CZ-Infokom/GeigerNode/GeigerNode Firmware Development.md

# GeigerNode Firmware — Master Development Prompt

You are developing firmware and performing hardware bring-up for a custom PCB called GeigerNode.

The firmware must be written for bare AVR silicon using the GNU AVR toolchain. Do not introduce Arduino, PlatformIO, vendor HALs, bootloaders, or unnecessary abstraction layers.

The immediate goal is SAFE HARDWARE BRING-UP of newly manufactured PCBs using an Atmel-ICE programmer.

Do not jump ahead to the complete firmware. Work through the bring-up phases in order and stop at explicit checkpoints.

Agent directives for this repository live in `.cursor/rules/`. This file remains the plan. The PROJECT STATUS section below is the persistence layer: update it when the phase, a checkpoint, a decision, or the stopping point changes. Numbered hardware, safety, and fuse sections stay as written unless the user changes those requirements.

======================================================================
PROJECT STATUS
======================================================================

Last updated: 2026-11-08

Where we are:
- Release `v0.2.1` is this commit, tagged on local `master` on 2026-11-08. Protocol version stays `2`. `GN_FW_PRE` is `0`, so `0x39`..`0x3C` are `00 02 01 00`. Capabilities `0x1F` (bit 4 = short-slice peaks). Map length is `0x50`. Host viewer: a chart with more than one trace draws each legend label as a switch; a click hides that trace and strikes the label through. History charts use the actual sample span on the time axis; the left edge is the oldest sample and the right edge is the newest. A full read of either latched peak still resets both latched values unless a newer slice raised the latch after the frozen snapshot. Each bank stores that latch generation. A consume that straddles the one-second publish keeps the new spike, including when NACK lands after the consume check and before the new winner is recorded. `make PROTOCOL=native` built text 15724, data 32, bss 1597, static RAM 1629, stack room 419, highest address `0x3D8B`. `make PROTOCOL=radsens` built text 8854, data 18, bss 825, static RAM 843, stack room 1205, highest address `0x22A7`. Host `make math-test` and `python3 firmware/host/viewer/test_decode.py` passed. Adversarial review before the tag: GPT, Gemini, and Opus hit a usage limit and fell back to Grok plus three inherit-critic passes. Round 1 found the latched-peak wipe; that and the remaining NACK-before-note hole are fixed in this image. No remaining hard blockers. Not pushed. Do not write fuses. Stay clear of the HV section. Do not raise 380 V or 2400 Hz.
- Host viewer time axis, 2026-11-08. History charts no longer snap elapsed time to round steps. The left edge is the oldest sample and the right edge is the newest, so a 0..90 s trace stays 0..90 s. The value axis still uses four round steps and the near-zero snap. Log time still maps that same actual span. Host `python3 firmware/host/viewer/test_decode.py` passed. Do not write fuses.
- Host viewer trace toggles, 2026-11-08. A chart with more than one trace draws each legend label as a switch. A click hides that trace and strikes the label through; another click draws it again. The value axis uses only the traces still drawn. A chart with one trace has no switch. Host `python3 firmware/host/viewer/test_decode.py` passed. Do not write fuses.
- Tag `v0.2.1-beta.4` is this commit on `feature/native-v2`, 2026-11-08. Annotated. Not merged to `dev` or `master`. Protocol version stays `2`. `GN_FW_PRE` is `4`, so `0x39`..`0x3C` are `00 02 01 04`. Capabilities `0x1F` (bit 4 = short-slice peaks). Map length is `0x50`. Bytes `0x00`..`0x3C` do not move. `0x3D` is reserved. `0x3E` is the peak span, 10..60 s, default 10, stored in EEPROM record version 2. A valid version-1 record still loads window, holdoff, and calibration, and the span stays 10 s. `0x40`/`0x48` are the window maximum (CPM × 10 and nSv/h) over the busiest full peak-span slice still inside the dose window. `0x44`/`0x4C` are the latched maximum since the previous consume. A full read of either latched register resets both latched values unless a newer slice raised the latch after that snapshot. An accepted span write clears both peaks. No peak updates until a full slice exists. RadSens is unchanged. `make PROTOCOL=native` built text 15582, data 32, bss 1593, static RAM 1625, stack room 423, highest address `0x3CFD`. `make PROTOCOL=radsens` built text 8854, data 18, bss 825, static RAM 843, stack room 1205, highest address `0x22A7`. Host `make math-test` and `python3 firmware/host/viewer/test_decode.py` passed. `make PROTOCOL=native flash` wrote 15614 bytes through Chir3n AVR Flasher as STK500v1 on CDC `if02`, then `make PROTOCOL=native verify` read the same 15614 bytes. The hex is data records and an end record only. No fuse bytes were written. The chip erase cleared EEPROM, so the window, holdoff, calibration, and peak span are back to 300 s, 200 µs, `604948`, and 10 s. After the programmer reset the LED is on for 500 ms, then 380 V starts. Stay clear of the HV section. Do not raise 380 V or 2400 Hz. Do not write fuses.
- Host viewer Y zero snap and inverted log time, 2026-11-08. The value axis pins the end nearer zero to 0 when that end is under 20% of the far end. `2..37` becomes `0..40`. `15..37` stays `10..50`. `-15..-1` becomes `-16..0`. `-18..-12` stays off zero. A ratio of exactly 20% stays zoomed. Linear time steps are unchanged. Log time now uses `-log(1 + (newest - t))`, so the oldest intervals shrink and the newest grow. Elapsed 0 stays on the left, and the cursor still reads real time. Host `python3 firmware/host/viewer/test_decode.py` passed. Do not write fuses.
- Host viewer graph scale, 2026-11-08. Each history chart snaps its value axis and its time axis to four equal steps. The step is the next larger value in 1, 2, 4, or 5 times a power of ten, which is where 0.4, 0.5, 4, and 5 come from. Time also uses 15 s, 30 s, 1 min, 2 min, 5 min, 10 min, 15 min, 30 min, and 1 h when one of those is the tighter fit. A 0 stays on 0. A narrow band such as pressure stays near its readings. Grid lines use the text color at about 28% opacity, horizontal on the value steps and vertical on the time steps. Log time still maps the trace with log(1 + t) and draws those same round times on that curve. Host `python3 firmware/host/viewer/test_decode.py` passed. Do not write fuses.
- GitHub Actions firmware workflow, 2026-11-08, on `feature/native-v2`. Not run on GitHub yet. `.github/workflows/firmware.yml` lints Python, runs `make math-test` and `python3 firmware/host/viewer/test_decode.py`, then builds both images with `EXTRA_CFLAGS=-Werror` and AVR 8-bit GNU Toolchain 4.0.0_52. A pushed tag `vMAJOR.MINOR.PATCH` publishes a GitHub release with `GeigerNode-<tag>-native_flash.hex`, `GeigerNode-<tag>-native.avr`, and the RadSens pair. A SemVer pre-release suffix (`-beta`, `-rc`, `-pre`, `-alpha`, and any other `-identifier`, including `-beta.2` and `-pre.1`) is a GitHub pre-release and is not marked Latest. The descriptors name LFUSE `E2`, HFUSE `D9`, EFUSE `F5`, and lock `FF`. The workflow stops at those files. Do not write fuses. Do not change those bytes. Stay clear of the HV section.
- Host viewer log time axis, 2026-11-08. The history header has a Log time checkbox. It maps elapsed time with log(1 + t) on every chart so the first sample at 0 s stays on the left and later intervals take less width. The value axis stays linear. The cursor still reads real elapsed time. Host `python3 firmware/host/viewer/test_decode.py` passed. Do not write fuses.
- Default holdoff is 200 µs, 2026-11-08, on `feature/native-v2`. Protocol version stays `2`. Version stays `0.2.1-beta.3`, not tagged. The native write range is still 0..300 µs. `GM_BLANKING_US` stays the 300 µs ceiling. `GM_BLANKING_DEFAULT_US` and `GN_HOLDOFF_DEFAULT_US` are 200. Histogram edges at that default are `249, 298, 396, 690, 1180, 2160, 5100, 10000`. RadSens has no holdoff register; INT0 uses the same 200 µs default. A blank EEPROM or `make flash` chip-erase returns to 300 s, 200 µs, and `604948`. `make PROTOCOL=native` built text 11398, data 28, bss 1521, static RAM 1549, stack room 499, highest address `0x2CA1`. `make PROTOCOL=radsens` built text 8854, data 18, bss 825, static RAM 843, stack room 1205, highest address `0x22A7`. Host `make math-test` and `python3 firmware/host/viewer/test_decode.py` passed. No ISP flash. The board still has the previous 300 µs default until it is programmed. Do not write fuses. Stay clear of the HV section. Do not raise 380 V or 2400 Hz.
- Internal version `0.2.1-beta.3` on `feature/native-v2`, 2026-11-08. Protocol version stays `2`. `GN_FW_PRE` is `3`, so `0x39`..`0x3C` are `00 02 01 03`. Not tagged. This image includes holdoff-scaled histogram bins. `make PROTOCOL=native` built text 11394, data 28, bss 1521, static RAM 1549, stack room 499, highest address `0x2C9D`. `make PROTOCOL=radsens` built text 8854, data 18, bss 825, static RAM 843, stack room 1205, highest address `0x22A7`. Host `make math-test` and `python3 firmware/host/viewer/test_decode.py` passed. `make PROTOCOL=native flash` wrote 11422 bytes through Chir3n AVR Flasher as STK500v1 on CDC `if02`, then `make PROTOCOL=native verify` read the same 11422 bytes. The hex is data records and an end record only. No fuse bytes were written. The chip erase cleared EEPROM, so the window, holdoff, and calibration are back to 300 s, 300 µs, and `604948`. After the programmer reset the LED is on for 500 ms, then 380 V starts. Stay clear of the HV section. Do not raise 380 V or 2400 Hz. Do not write fuses.
- Holdoff-scaled histogram bins, 2026-11-08, on `feature/native-v2`. Protocol version stays `2`. Nine exclusive bins stay at `0x26`..`0x37`. Holdoff `0` keeps `50, 100, 200, 500, 1000, 2000, 5000, 10000` µs. Any other holdoff `H` starts bin 0 at `H` and maps those bounds onto `[H, 10000]`: `edge[i] = H + classic[i] * (10000 - H) / 10000`, last edge `10000`. Default 300 µs is `349, 397, 494, 785, 1270, 2240, 5150, 10000`. Labels are not on the bus; the viewer derives them from `0x20`. An accepted holdoff write still clears the bins and rebuilds the edges. RadSens is unchanged. `make PROTOCOL=native` built text 11388, data 28, bss 1521, static RAM 1549, stack room 499, highest address `0x2C97`. `make PROTOCOL=radsens` built text 8854, data 18, bss 825, static RAM 843, stack room 1205, highest address `0x22A7`. Host `make math-test` and `python3 firmware/host/viewer/test_decode.py` passed. No ISP flash. Do not write fuses. Stay clear of the HV section. Do not raise 380 V or 2400 Hz.
- Native image flashed over Flipper ISP, 2026-11-08, on `feature/native-v2`. `make PROTOCOL=native flash` wrote 11470 bytes through Chir3n AVR Flasher as STK500v1 on CDC `if02`, then `make PROTOCOL=native verify` read the same 11470 bytes. The hex is data records and an end record only. No fuse bytes were written. The chip erase cleared EEPROM, so the window, holdoff, and calibration are back to 300 s, 300 µs, and `604948`. Firmware version bytes are `00 02 01 02`. `0x1A` keeps counting past the 300 s window. After the programmer reset the LED is on for 500 ms, then 380 V starts. Stay clear of the HV section. Do not raise 380 V or 2400 Hz. Do not write fuses.
- Run elapsed and viewer settings, 2026-11-08. Native `0x1A` is milliseconds since this RUN started publishing. It no longer freezes near 300000 when the 300 s window fills. Dose and CPM still use the window sum, which stays near `window_s × 1000` ms. A new RUN starts `0x1A` at 0. Saturation at `0xFFFFFFFF` sets `OVERFLOW`. The viewer shows that register in seconds. Edit → Settings… sets the in-memory graph length, default 7200, and the poll interval, default 1 s, range 1..3600 s. `make PROTOCOL=native` built text 11458, data 12, bss 1505, static RAM 1517, stack room 531, highest address `0x2CCD`. Host `python3 firmware/host/viewer/test_decode.py` passed. No ISP flash. Do not write fuses. Stay clear of the HV section. Do not raise 380 V or 2400 Hz.
- Host viewer layout, 2026-11-08. The Arm checkbox is gone. Edit → Registers… opens a modal with the native or RadSens write fields. Each write still confirms, default Cancel. View → Histogram… opens the nine bins in their own window, with Clear histogram in that window. Radiation and the BME680 readings sit on one row. Dose and CPM charts are the row under that, and temperature, pressure, humidity, and gas share the bottom row, so a 1920×1080 window shows the readings and all six graphs. RadSens `0x09`/`0x0A` are still not read. HV 1 still starts 380 V and HV 0 stops it. The setpoint stays 380 V at 2400 Hz. Do not write fuses.
- Firmware version registers, 2026-11-08, on `feature/native-v2`. Protocol version stays `2`. `0x39`..`0x3C` are major, minor, patch, and pre-release. This image is `00 02 01 02`, shown as `0.2.1-beta.2`. Pre-release `0` is a release. Writes there are ignored. The map is 61 bytes. A pointer of `0x3D` or higher is stored as `0x00`. After `0x3C`, further bytes in that burst are `0xFF`. Bytes `0x00`..`0x38` do not move. The viewer reads `0x00` for 32 bytes and `0x20` for 29, and shows the version in the Firmware row, the mode line, and the window title. `0xFF 0xFF 0xFF 0xFF` is an older image and the row says it is not in that image. RadSens `0x01` stays `0x04`. `make PROTOCOL=native` built text 11282, data 12, bss 1500, static RAM 1512, stack room 536, highest address `0x2C1D`. Host `python3 firmware/host/viewer/test_decode.py` passed. No ISP flash. Do not write fuses. Stay clear of the HV section. Do not raise 380 V or 2400 Hz.
- Tag `v0.2.1-beta.2` is `1872896` on `feature/native-v2`, 2026-11-08. Annotated, not a `master` release. This rebuild includes the histogram clear from `0x38` and from an accepted holdoff write. `make PROTOCOL=native` built text 11240, data 12, bss 1492, static RAM 1504, stack room 544, highest address `0x2BF3`. `make PROTOCOL=radsens` built text 8866, data 2, bss 809, static RAM 811, stack room 1237, highest address `0x22A3`. HEX files are data records and an end record only. They replaced the earlier same-name pair on Chir3n at `/ext/apps_data/avr_isp/`. Card MD5 matched: `GeigerNode-v0.2.1-beta.2-native_flash.hex` (`de0cc60374520a62d30c0df434bdf880`) and `GeigerNode-v0.2.1-beta.2-native.avr` (`1675ac588b5305b1d518a7d21894abe2`), `GeigerNode-v0.2.1-beta.2-radsens_flash.hex` (`473ef0390efb426b2495cb78afa535a4`) and `GeigerNode-v0.2.1-beta.2-radsens.avr` (`34aaf471937b89e7c0460cd692336345`). The descriptors name the approved fuses LFUSE `E2`, HFUSE `D9`, EFUSE `F5`, lock `FF`. Do not change those bytes. The AVR itself was not programmed. HV stays 380 V at 2400 Hz. Do not write fuses.
- Native histogram clear, 2026-11-07, on `feature/native-v2`. Protocol version stays `2`. Write `01` at `0x38` zeros the nine bins, the shortest gap, and the on-chip close log. Dose, CPM, and the count window stay. The next accepted edge starts a new gap series. An accepted holdoff write at `0x20` does the same clear; a same-value holdoff write does not. Window writes still do not clear. The published bank updates immediately. The viewer has a Clear histogram button, armed and confirmed like the other native writes, encoding `w 67 38 01`. Host `make math-test` and `python3 firmware/host/viewer/test_decode.py` passed. This host has no `/opt/avr8-gnu-toolchain-4.0.0` or `/opt/avr-gcc-15.2.0`, so AVR size was not recorded here. No ISP flash. Do not write fuses. Stay clear of the HV section. Do not raise 380 V or 2400 Hz.
- Host viewer native poll, 2026-11-07. The ESP32-C3 bridge prints `ERROR: Invalid read length` for any read longer than 32 bytes, so `x 67 00 / 57` never reaches the AVR. The viewer now reads `0x00` for 32 bytes and `0x20` for 25. Each transfer writes that pointer. RadSens `0x09`/`0x0A` are still not read. Do not write fuses.
- Flipper images `v0.2.1-beta.2`, 2026-11-07, on Chir3n at `/ext/apps_data/avr_isp/`. This pair is the native histogram at `0x22`..`0x38` plus the static-RAM cuts (no TWI `txn[]` copy, fault-LED tables encoded in `led_fault()`, RadSens without `cps_extra[]`). `make PROTOCOL=native` built text 11232, data 12, bss 1492, static RAM 1504, stack room 544, highest address `0x2BEB`. `make PROTOCOL=radsens` built text 8962, data 2, bss 809, static RAM 811, stack room 1237, highest address `0x2303`. HEX files are data records and an end record only. Card MD5 matched the local files: `GeigerNode-v0.2.1-beta.2-native_flash.hex` (`b54d6fc677e2c7b4034cf45d81042544`) and `GeigerNode-v0.2.1-beta.2-native.avr` (`1675ac588b5305b1d518a7d21894abe2`), `GeigerNode-v0.2.1-beta.2-radsens_flash.hex` (`445404a39d23b4a960754f266830dad4`) and `GeigerNode-v0.2.1-beta.2-radsens.avr` (`34aaf471937b89e7c0460cd692336345`). The descriptors name the approved fuses LFUSE `E2`, HFUSE `D9`, EFUSE `F5`, lock `FF`. Do not change those bytes. Earlier card files, including beta.1, are unchanged. These images have not been flashed to the AVR. HV stays 380 V at 2400 Hz. Do not write fuses.
- Static RAM cuts, 2026-11-07, on `feature/native-v2`. RadSens dropped `cps_extra[300]` and `stat_elapsed_ms`; publish still uses `cps_len * 1000` and `dyn_len * 1000`. Native keeps the 400 s slip array for dose and CPM. Both images dropped the TWI `txn[]` copy: a read freezes the published bank pointer, and publish writes the other bank. The fault LED dwell and level are encoded in `led_fault()` so the SRAM tables are gone. The native ring, histogram registers `0x22`..`0x38`, and the on-chip close log stay. `make PROTOCOL=native` built text 11232, data 12, bss 1492, static RAM 1504, stack room 544, highest address `0x2BEB`. `make PROTOCOL=radsens` built text 8962, data 2, bss 809, static RAM 811, stack room 1237, highest address `0x2303`. Host `make math-test` and `python3 firmware/host/viewer/test_decode.py` passed. No ISP flash. Do not write fuses. Stay clear of the HV section. Do not raise 380 V or 2400 Hz.
- Host viewer layout and writes, 2026-11-07, on `feature/native-v2`. The Radiation group is split into Measurements and Fixed. The nine inter-arrival bins are horizontal bars, with the shortest accepted gap. Export CSV writes the in-memory series and, when the map has it, the latest histogram. Register writes stay disabled until the warning dialog is accepted, and each write confirms again. Native writes are calibration `0x12` (non-zero Q16.16), window `0x1E` (1..400 s), and holdoff `0x20` (0..300 µs). RadSens writes are address `0x10`, sensitivity `0x12`, low-power `0x0C`, LED `0x14`, and HV generator `0x11`. HV 1 starts 380 V and HV 0 stops it. The setpoint stays 380 V at 2400 Hz. Address `0x76` is called out because it collides with the BME680. RadSens `0x09`/`0x0A` are still not read. Do not write fuses. Stay clear of the HV section.
- Native inter-arrival histogram on the I2C map, 2026-11-07. Protocol version stays `2`. Capabilities become `0x0F` (bit 3 = histogram). Map length is `0x39`. `0x22`..`0x25` is the shortest accepted gap this RUN (`0xFFFFFFFF` until the second accepted edge). `0x26`..`0x37` are the nine exclusive INT0 bins already kept in `gm_counter.c`, big-endian uint16, under 50 µs through 10 ms and above. `0x38` bit 0 is set when any bin is at 65535. Those bins count accepted gaps since `gm_counter_open_window()` on this RUN; they are not the rolling dose window at `0x16`. The close log stays on-chip. Writes into `0x22`..`0x38` are ignored. A saturated bin does not set dose `OVERFLOW`. The default 300 µs holdoff still empties the bins under 300 µs. Bytes `0x00`..`0x21` do not move. RadSens is unchanged. `make PROTOCOL=native` built text 11064, data 40, bss 1547, static RAM 1587, stack room 461, highest address `0x2B5F`. `make PROTOCOL=radsens` built text 9178, data 30, bss 1132, highest address `0x23F7`. Host `make math-test` and `python3 firmware/host/viewer/test_decode.py` passed. The viewer reads 57 bytes from `0x00` and shows the nine bins. No ISP flash. Do not write fuses. Stay clear of the HV section. Do not raise 380 V or 2400 Hz.
- Native protocol v2, tag `v0.2.1-beta.1`, 2026-11-07, on `feature/native-v2`. Not merged to `dev` or `master`. Version byte `0x02`. Capabilities `0x07`. `0x12` is a 4-byte calibration write, rejected when zero or short. `0x1E` is the static window, 1..400 s, default 300. `0x20` is the holdoff, 0..300 µs, default 300. A short or out-of-range write is ignored. The native history ring is 400 s. Shrinking drops the oldest seconds. Lengthening keeps seconds still in that ring. Dose and CPM follow on the next one-second snapshot. Settings are stored at EEPROM 960 with magic `0xC3`. A bad record loads the defaults. The default calibration stays `604948`. RadSens stays firmware `0x04`, static window 300 s, holdoff 300 µs, and its own magic at the same EEPROM address. `make PROTOCOL=native` built text 10632, data 40, bss 1478, highest address `0x29AF`. `make PROTOCOL=radsens` built text 9178, data 30, bss 1132, highest address `0x23F7`. Host `make math-test` passed. No ISP flash. HEX files are data records and an end record only. They are on Chir3n at `/ext/apps_data/avr_isp/` as `GeigerNode-v0.2.1-beta.1-native_flash.hex` (MD5 `acbc2112f6cc11ac9c2e91f089151054`) and `GeigerNode-v0.2.1-beta.1-native.avr` (MD5 `b4eab971fc4908940d97cfae3e1336ea`), and `GeigerNode-v0.2.1-beta.1-radsens_flash.hex` (MD5 `5208975558d6b013e4828fee05e49fce`) and `GeigerNode-v0.2.1-beta.1-radsens.avr` (MD5 `efb2374e5075bd8695cdff5d3ee62316`). The descriptors name the approved fuses LFUSE `E2`, HFUSE `D9`, EFUSE `F5`, lock `FF`. Do not change those bytes. Earlier card files are unchanged. These images have not been flashed. HV stays 380 V at 2400 Hz. Do not write fuses. Do not replace 65 from a host calibration write.
- Static window is 300 s as of 2026-11-07. `APP_STATIC_S` is 300 one-second buckets for both protocols. `WINDOW_FULL` means 300 s collected, and a full ring keeps `elapsed_ms` near 300000. The dynamic window stays 1–122 s. `make PROTOCOL=native` built 8896 bytes of text, bss 1162, highest address `0x22BF`. `make PROTOCOL=radsens` built 8962 bytes of text, bss 1132, highest address `0x2301`. Host `make math-test` passed. No ISP flash. The HEX files are data records and an end record only. They are on Chir3n at `/ext/apps_data/avr_isp/` as `GeigerNode-static300-native_flash.hex` (MD5 `42ddebab20c1e3ea41824d6c3bf75e5b`) and `GeigerNode-static300-native.avr` (MD5 `3e8314c8afcf95821076a2015bf72c70`), and `GeigerNode-static300-radsens_flash.hex` (MD5 `4d4c06ab864292e57ca16565e79a8c50`) and `GeigerNode-static300-radsens.avr` (MD5 `d3dedf3de8edb025b049a8444c1867f2`). The descriptors name the approved fuses LFUSE `E2`, HFUSE `D9`, EFUSE `F5`, lock `FF`. Do not change those bytes. The earlier `GeigerNode-holdoff300-*` files are the 500 s images and were left on the card, as were the v0.2.0 files. Holdoff stays 300 µs. Firmware byte stays `0x04`. Flash AVR chip-erases EEPROM. These images have not been flashed. HV stays 380 V at 2400 Hz. Do not write fuses.
- 300 µs holdoff trial, 2026-11-07, approved after 23 counted blinks in one minute against a 55.3 CPM window. `GM_BLANKING_US` is 300. An accepted falling edge ignores later edges for 300 µs, and an ignored edge does not move that stamp. `make PROTOCOL=native` built 8896 bytes of text on 2026-11-07. No Flipper ISP `if02` port was present, so avrdude did not flash it. The same day the HEX (highest address `0x22BF`, data records and an end record only) and descriptor were copied to Chir3n at `/ext/apps_data/avr_isp/` as `GeigerNode-holdoff300-native_flash.hex` (MD5 `d69cac95231f70bc8cb73e48aeb3b9ed`) and `GeigerNode-holdoff300-native.avr` (MD5 `baed70e4154f7508bc037452cc8268d0`). The descriptor names the approved fuses LFUSE `E2`, HFUSE `D9`, EFUSE `F5`, lock `FF`. Do not change those bytes. `GeigerNode-v0.2.0-native` on the card is unchanged. Flash AVR chip-erases EEPROM, then the reset leaves the LED on for 500 ms and 380 V starts. HV stays 380 V at 2400 Hz. The 100 µs cap stays. Do not write fuses. After `make PROTOCOL=native flash` the programmer reset leaves the LED on for 500 ms, then 380 V starts. On 2026-11-07 after Flash AVR the user reported the count matches the eye. The extra edges inside 300 µs were the ones merged into one blink. Keep 300 µs. Do not lengthen it from this report. A numeric CPM and µSv/h for a full window after the flash were not recorded. The same day `make PROTOCOL=radsens` built 8962 bytes of text, highest address `0x2301`, data records and an end record only. That image is on Chir3n at `/ext/apps_data/avr_isp/` as `GeigerNode-holdoff300-radsens_flash.hex` (MD5 `958e311185fac40e5a890e6eeed49056`) and `GeigerNode-holdoff300-radsens.avr` (MD5 `2fe5615dd1113351b4e283963c521d4d`). Firmware byte stays `0x04`. The descriptor uses the same approved fuses and lock. `GeigerNode-v0.2.0-radsens` on the card is unchanged. Flash AVR chip-erases EEPROM, so the RadSens address returns to `0x66` and sensitivity to 65. Stay clear of the HV section.
- Native v1 mantle check, 2026-11-06, viewer on `feature/i2c-viewer`. With the mantle in the full window the register held 31401 counts over 500000 ms, 3768 CPM, 34.8 µSv/h, sequence 2170. RadiaCode read 1.4 µSv/h beside it. That ratio is the pulse count: 31401 counts in 500 s is 3768 CPM, and 3768 times 9.23077 nSv/h per CPM is 34.8 µSv/h. The same SBM-20 factor (65 impulses/µR) predicts about 152 CPM at 1.4 µSv/h. The mantle stays an uncalibrated beta-plus-gamma source and does not replace 65. Do not add dead time from this pair. The LED during the 35 µSv/h plateau was not recorded; at a true 3768 CPM the 40 ms LED stretch overlaps, so the LED would look continuously lit. After the mantle was taken away the LED blinked about once a second while the ring still showed 14.3 µSv/h and 1554 CPM (12954 counts, sequence 2595). That slow fall is the 500 s ring. Stay clear of the HV section. Do not raise 380 V or 2400 Hz. Do not write fuses.
- Native v1 background, 2026-11-07, same image, sequence 85656. Full window: 461 counts, 500000 ms, 55.3 CPM, 511 nSv/h (0.511 µSv/h). Status `0x07` is `VALID|WINDOW_FULL|HV_FOLLOWING` with 0 attempts; the viewer reads attempts from `0x0C` and flags from `0x0D`. A second GM counter and the RadiaCode beside it read 0.15 µSv/h and can read 0.10 µSv/h. On the SBM-20 factor those references are about 11–16 CPM, so this window is about 3.4× the 0.15 reading and about 5× the 0.10 reading. A timed count the same morning was 23 LED blinks in one minute. The LED holds for 40 ms and retriggers, so edges inside that hold are one blink and several counts. 23 blinks against the 55.3 CPM window is about 2.4 edges per blink. Counting blinks only, 23 CPM is 0.212 µSv/h on the same factor. This background pair does not replace 65. Do not add dead time from the blink count. The mantle ratio and this background ratio are not one scale factor. Stay clear of the HV section. Do not raise 380 V or 2400 Hz. Do not add dead time. Do not write fuses.
- Host I2C measurement viewer on `feature/i2c-viewer`, 2026-11-06. Path `firmware/host/viewer/geigernode_viewer.py`. Run with `python3 firmware/host/viewer/geigernode_viewer.py`. It talks to the ESP32-C3 USB-I2C bridge at 115200 (`x` / `w` / `s`). Native `0x67` and RadSens `0x66` are detected from a scan; RadSens never reads `0x09`/`0x0A` and never bursts through them. Register writes are warning-gated; see the 2026-11-07 viewer note. BME680 at `0x76` is forced-mode T×2 P×4 H×1 with a 300 °C / 100 ms heater, and only that chip is written. Canned decode tests: `python3 firmware/host/viewer/test_decode.py`. Live pass the same day: scan `0x67`/`0x76`, native dose and CPM updating, BME680 temperature/pressure/humidity/gas. The window keeps in-memory graphs of dose (µSv/h), count rate (CPM; RadSens CPM is µR/h × S / 60), and BME680 temperature, pressure, humidity, and gas. The buffer holds about two hours at one sample per second and is not written to disk. Hovering a graph draws a cursor at the nearest sample on every chart and a readout of that time and the values on the chart under the pointer. Native status is a big-endian uint16: `0x0C` is HV attempts and `0x0D` is the flag byte. `00 07` is 0 attempts and `VALID | WINDOW_FULL | HV_FOLLOWING`. Stay clear of the HV section. Do not raise 380 V or 2400 Hz. Do not write fuses.
- Release `v0.2.0` is this commit, tagged on local `master` on 2026-11-06. It is native I2C protocol v1 at `0x67`, the RadSens image at `0x66` (firmware byte `0x04`), and PCB rev A in `hardware/`. Standalone Flipper AVR Flasher images are `firmware/flipper/geigernode-native.hex` (8982 bytes text) and `firmware/flipper/geigernode-radsens.hex` (9048 bytes text), built with `F_CPU=8000000UL` and avr-gcc 15.2.0. Both files are Intel HEX data records plus an end record. Highest addresses are `0x2315` and `0x2357`. There are no EEPROM, fuse, or lock records. Copy one file to the Flipper SD card and select it with Flash AVR. That operation chip-erases EEPROM. Do not write fuses. After the programmer reset the LED is on for 500 ms, then 380 V starts. Stay clear of the HV section. Do not raise 380 V or 2400 Hz. Do not add dead time. Host `make math-test` passed. The native 8982-byte image was already verified over Flipper STK500v1. The 9048-byte RadSens rebuild and both SD-card Flash AVR paths have not been run. Not pushed. On 2026-11-06 the images were copied to Chir3n at `/ext/apps_data/avr_isp/` as `GeigerNode-v0.2.0-native.avr` plus `GeigerNode-v0.2.0-native_flash.hex`, and `GeigerNode-v0.2.0-radsens.avr` plus `GeigerNode-v0.2.0-radsens_flash.hex`. SD-card MD5 matched the local files. Those `.avr` descriptors name ATmega328PB signature `1E 95 16` and the approved fuses LFUSE `E2`, HFUSE `D9`, EFUSE `F5`, lock `FF`. There is no EEPROM file. Choosing Flash AVR in the app writes the flash image and those fuse and lock bytes. Do not change the descriptor fuse bytes.
- Adversarial review before `v0.2.0`, 2026-11-06: GPT, Gemini, and Opus hit a usage limit and fell back to Grok plus three inherit-critic passes. No hard blockers. Same-model fallback, as with `v0.2.0-pre.1`.
- PCB rev A is in `hardware/`, copied 2026-11-06 from `/mnt/Work/Infokom/Meshtastic/HW/GeigerNode` on `feature/pcb-rev-a` and merged to `dev`. This repo is the source of truth for the board files. KiCad backups and `*.kicad_prl` stay untracked. `hardware/production/` is the 2026-09-17 export (`GeigerNode_A.zip`, BOM, positions, designators, IPC netlist). The schematic and board files are timestamped a few minutes after that export, and `GeigerNode.kicad_pro` was last touched 2026-10-28. Regenerate the production outputs before the next fab order. The Infokom directory was left in place.
- Native I²C protocol for issue #4 merged to local `dev` on 2026-11-06. The I2C map is chosen at compile time: `make PROTOCOL=native` is protocol v1 at `0x67`; `make PROTOCOL=radsens` is the ClimateGuard map at `0x66`. There is no Makefile default. Host `make math-test`: 90 pulses / 500000 ms → CPM × 10 = 108 and 100 nSv/h, Q16.16 calibration `604948`. `make PROTOCOL=native flash` wrote 8982 bytes and verified them over Flipper STK500v1. EEPROM was chip-erased. No fuse bytes were written. ESP32-C3 100 kHz: scan `0x67` and `0x76` only. `x 67 00 / 2` → `47 4E`. `x 67 02 / 1` → `01`. Capabilities `03`. Calibration `00 09 3B 14`. Status `01 05` (`VALID` + `HV_FOLLOWING`, 1 attempt). Repeated reads do not clear the window count. Sequence and elapsed advance about once per second. Bytes after `0x1D` are `FF`. Pointer `0x1E` restarts at `0x00`. STOP+START also returned `47 4E`. BME680 `0xD0` is `0x61`. HV, 380 V, 2400 Hz, the 100 µs cap, and fuse bytes stay unchanged. Two-hour no-poll soak is still open. Stay clear of the HV section. Do not raise 380 V or 2400 Hz. Do not add dead time. Do not write fuses. Do not merge to `master` until asked.
- Adversarial review before `v0.2.0-pre.1`, 2026-11-06: GPT/Gemini/Opus hit a usage limit and fell back to Grok plus three inherit-critic passes. No hard blockers. Write path `0x10`/`0x11`/`0x12`/`0x14` was not exercised (ESP32-C3 bridge is read-only). Solar Node was not on the bench. Tag path is `feature/hw-twi0-poc` → `dev` → `master`.
- Hardware TWI0 RadSens integration for issues #1, #2, and #3, 2026-11-06, on `feature/hw-twi0-poc`. The bit-banged slave is preserved on `fallback/bitbang-i2c`. Production `twi_slave.c` is the PoC TWI0 state machine with the ClimateGuard map: dual-bank radiation latch on SLA+R, pulse 0x09/0x0A snapshot-and-clear, writes applied in main, pointer kept across 0xA0, TWSTO only on bus error. Firmware is `0x04`. `make flash` wrote 8724 bytes and verified them over Flipper STK500v1. EEPROM was chip-erased. No fuse bytes were written. ESP32-C3 100 kHz: scan `0x66` and `0x76`. `r 66 00 2` → `7D 04`. Address `0x66`, HV `0x11` = `1`, sensitivity `41 00`, LED `1`. A 21-byte read from `0x00` returned `7D 04 00` then live radiation, address `0x66` at `0x10`, and `41 00`. `0x09` returned `00 0D` then `00 00` on the next read. STOP+START also returned `7D 04` and `41 00`. BME680 `0xD0` is `0x61` (50/50). Device-ID burst 198/200 after serial warmup. Extended ESP32-C3 pass 2026-11-06 later the same morning: 28/28 checks, 1000/1000 `7D 04`, 300/300 STOP+START, 200/200 interleaved sensitivity and BME680 `0x61`, 500/500 three-byte `0x06` with no `0x8000` glitch (253–268), pointer `0x15` restarts at `0x00`, bytes after `0x14` are `FF`. HV, 380 V, 2400 Hz, the 100 µs cap, and dose math are unchanged. After the programmer reset the LED is on for 500 ms, then 380 V starts. Stay clear of the HV section. Do not raise 380 V or 2400 Hz. Do not add dead time.
- Hardware TWI0 proof of concept for issue #3, 2026-11-06, on `feature/hw-twi0-poc`. The image that failed on the bus was `b87695c`. It already used `TWI0_vect` and the PB registers `TWCR0` / `TWDR0` / `TWSR0` / `TWAR0`; a 328P mix-up is not the recorded cause. A read with no new pointer kept `reg_ptr`, so after a dose read every later address returned that 24-bit high byte (`0x00`). Status `0xA0` is STOP and repeated START and that image did not read `TWDR0` there. The `default` arm wrote `TWSTO` for unlisted statuses, including data NACK `0x88`; that is the code behind the note that hardware TWI could hold SCL. The bit-bang commit's C-prologue miss is the first pin-change attempt, not a TWI0 bug. There was no status trace. The PoC keeps the pointer across `0xA0`, uses it once on SLA+R, otherwise transmits from `0x00`, and writes `TWSTO` only for status `0x00`. Live ISP is Flipper Chir3n `[AVR] AVR Flasher` as `stk500v1` on CDC `if02`. Signature `0x1E 0x95 0x16`. Fuses read-only `0xE2` / `0xD9` / `0xF5`. Do not use Flipper CLI `if00`. Atmel-ICE remains `PROGRAMMER=atmelice_isp PORT=usb`. `make flash-twi-hw-test` wrote 842 bytes and verified them on 2026-11-06. EEPROM was chip-erased (HFUSE `0xD9`). No fuse bytes were written. PB1 stays low and HV stays off. I2C host is the ESP32-C3 serial bridge (`/mnt/Work/dev/PlatformIO/Projects/I2C_bridge`, USB-JTAG `ttyACM0`, 115200 baud, 100 kHz, `r` = repeated START, `R` = STOP+START). 2026-11-06 scan lists `0x66` and `0x76`. Repeated-START and STOP+START both returned `7D 03` at `0x00`, `00 00 3C` at `0x06`, and `41 00` at `0x12`. A 21-byte read from `0x00` was `7D 03 00 00 00 00 00 00 3C ... 41 00 00`. BME680 `0x76` register `0xD0` is `0x61` (50/50). Burst: `0x00` 197/200 then 999/1000 (the empties were serial warmup), `0x06` 200/200, `0x12` 200/200, STOP+START 100/100, mixed 300/300. Status trace after a long read is `0xB8` then `0xC0`. This is the gate for moving the RadSens map onto TWI0. Do not raise 380 V or 2400 Hz. Do not add dead time. Stay clear of the HV section.
- SBM-20 image flashed and verified on 2026-11-05. `make flash` wrote 8902 bytes and verified them. `make verify` read the same 8902 bytes. EEPROM was chip-erased, so address is `0x66` and sensitivity is 65 (`0x41 0x00` at `0x12`). Firmware is `0x03`. The live profile is `gm_tube_sbm20`. Dose math is unchanged: µR/h = CPM * 60 / S. The Ra-226 RadSens-module value 105 is not loaded. HV stays 380 V at 2400 Hz. Blanking stays 0. After the programmer reset the LED is on for 500 ms, then 380 V starts. The first 2026-11-05 flash attempt failed with AVR sign-on `0xa0`; the retry succeeded after the ISP header was reseated. No fuse bytes were written. The JNA DR-M3 comparison has not been run. Do not replace 65 until that measurement is accepted. Record the source label (nuclide, stated rate, distance), a background, and a source window long enough for the 500 s static register. Keep raw counts from `0x09` as well as `0x06`. `S_empirical = net_CPM * 60 / net_µR/h`. One geometry does not overwrite 65. Do not raise 380 V or 2400 Hz. Do not add dead time. Stay clear of the HV section.
- RadSens mimic built on 2026-10-07, not flashed. Static radiation is the last 500 s. Dynamic radiation grows to 122 s and shrinks to the last 10 s when the recent rate and the older rate differ by more than a factor of two, with at least 4 counts on the busier side. Dose uses the integer sensitivity register, default 138. `0x09` clears on read. Host writes can stop and start HV, set the LED enable, and store address and sensitivity at EEPROM 960. `0x0C` is accepted and does not change the converter. Every reset holds the LED on for 500 ms, then starts 380 V. An operational HV fault (startup timeout, settle timeout, or the 400 V abort) forces PB1 low and retries, four starts total, with the switch off for 30 s, then 2 min, then 10 min. An illegal pulse or rate gives up immediately. Give-up forces `0x11` to 0; a later write of `1` starts a new budget. Ten minutes in run clears the budget. `0x0B` is the HV status. Firmware is `0x02`. `make flash` chip-erases EEPROM and restores `0x66` and 138. Do not raise 380 V or 2400 Hz. Do not add dead time. Stay clear of the HV section.
- Flipper I2C bridge on 2026-10-07: scan lists `0x66` and the BME680 at `0x76`. `i2c_read 0x66 0x00 2` returned `0x7D 0x01`. `i2c_read 0x66 0x12 2` returned `0x8A 0x00` (sensitivity 138). `i2c_read 0x66 0x10` returned `0x66`. A 21-byte read from `0x00` returned the map with device ID `0x7D`, address `0x66` at `0x10`, and sensitivity `0x8A 0x00`. The BME680 chip ID read returned `0x61`. The pin-change handler reads the address itself; a C prologue was missing Flipper's first bit. The register map is `firmware/i2c-register-map.md`. Hardware TWI0 stays off. SCL is never driven. Do not raise 380 V or 2400 Hz. Do not add dead time. Stay clear of the HV section; every reset starts the 5 s delay.
- Host I2C map was wrong on 2026-10-05. First dump: `0x00` returned `0x00 0x00`, then `0x3B 0xAA` with the source, every address the same, and the value stayed after the source left. After the first pointer change, every address returned `0x00`. That is the high byte of a leftover 24-bit dose register, not a cleared device ID. A read now starts at `0x00` unless the host actually wrote a pointer byte. Do not take leftover TWDR after STOP as a pointer. Static radiation at `0x06` is the last 60 s. Dynamic at `0x03` is the last 10 s. After flash, a naked read or a read of `0x00` must return `0x7D`. Do not raise 380 V or 2400 Hz. Do not add dead time.
- RadiaCode comparison background, 2026-10-05, mantle in another room. GeigerNode `make read-gm-test`: GM_TEST_OK, EEPROM COMPLETE. 600 s, 91 measurement pulses, 9.1 CPM, one edge before the window, min CPS 0, max CPS 2, minimum interval 154 µs. Exclusive bins 0 / 0 / 7 / 0 / 0 / 0 / 0 / 0 / 83. All seven gaps below 500 µs are 154–170 µs. HV 379–380 V at ADC 883–887, final count 886, pulse 80 µs, 0 ms at 100 µs. Blanking 0. RadiaCode accumulated 10 nSv in 10 min, which is 0.060 µSv/h. RadiaCode comparison pair 1, 2026-10-05, 3 cm through the 5 mm aluminum plate. GeigerNode `make read-gm-test`: GM_TEST_OK, EEPROM COMPLETE. 600 s, 231 measurement pulses, 23.1 CPM, min CPS 0, max CPS 3, minimum interval 147 µs. Exclusive bins 0 / 0 / 19 / 0 / 0 / 0 / 0 / 0 / 211. The first 16 of 19 gaps below 500 µs are 147–174 µs. HV 378–381 V at ADC 882–888, final count 886, pulse 80 µs, 0 ms at 100 µs. Blanking 0. Background for this checkpoint is 9.1 CPM and 0.060 µSv/h. The 3 cm pair is complete: the 23.1 CPM window and the later RadiaCode accumulation of 20 nSv in 10 min, or 0.120 µSv/h, were both at 3 cm. The earlier 200 nSv/h figure was a high live display. Net is 14.0 CPM and 0.060 µSv/h, about 233 CPM per µSv/h, `S_empirical` about 123 impulses/µR. That net dose is only 10 nSv, so keep the provisional 137.5. RadiaCode direct, plate contact, 10-minute average 0.50 µSv/h. GeigerNode direct, 2026-10-05: `make read-gm-test` returned GM_TEST_EXCESSIVE_FAST_PULSES, EEPROM COMPLETE. 600 s, 650 measurement pulses, 65.0 CPM, two edges before the window, min CPS 0, max CPS 7, minimum interval 32 µs. Exclusive bins 5 / 0 / 53 / 0 / 2 / 0 / 1 / 3 / 585. The first stored gap is 33 µs; the other fifteen stored gaps are 151–185 µs. HV 378–380 V at ADC 881–887, final count 886, pulse 80 µs, 0 ms at 100 µs. Blanking 0. Net against the recorded background is 55.9 CPM and 0.440 µSv/h, about 127 CPM per µSv/h, `S_empirical` about 67 impulses/µR. The comparison does not converge across geometry: 233 CPM per µSv/h at 3 cm versus 127 in contact. The 3 cm result is consistent with the published lower sensitivity limit; contact is not a valid coefficient transfer because the near field varies sharply across the RadiaCode and the long SI-29BG sensitive volumes. Treat the checkpoint as inconclusive, not as evidence that the datasheet coefficient is wrong. The user accepted 137.5 impulses/µR on 2026-10-05. Do not add dead time. Do not raise 380 V or 2400 Hz.
- SI-29BG RadSens I2C address `0x66` answers. The first host dump did not record distinct register bytes: every address returned the same two live bytes. The pointer and 60 s static window are the fix waiting to flash. HV starts after a 5 s delay on every reset. There is no arm word. The LED is off in RUN and flashes on for each pulse. I2C writes cannot start or stop HV. Do not raise 380 V or 2400 Hz. Do not add dead time.
- SBM-20 datasheet basepoint from 2026-10-05 is the installed default as of 2026-11-05: `S = 65 impulses/µR`, midpoint of the published Cs-137 response of 240–280 counts/s at 4 µR/s (60–70 impulses/µR). This corresponds to 0.92308 µR/h per CPM, or about 0.008095 µSv/h per CPM for orientation only. Published electrical values remain 400 V recommended, 350–475 V operating range, 190 µs dead time at 400 V, and 5.1 MΩ recommended anode resistance. The setpoint stays 380 V at 2400 Hz with blanking 0. The 400 V recommendation and the 190 µs dead time were not applied. Confirm the ballast before the first flash. The JNA DR-M3 comparison has not been run.
- SI-29BG 10-minute background passed on 2026-10-05. `make read-gm-test` returned GM_TEST_OK, EEPROM COMPLETE. 600 s, 75 measurement pulses, 7.5 CPM, one edge before the window, min CPS 0, max CPS 2, minimum interval 156 µs. Exclusive bins 0 / 0 / 1 / 0 / 0 / 0 / 0 / 0 / 73. The only gap below 500 µs is 156 µs. HV 378–380 V at ADC 882–887, final count 885, pulse 80 µs for the whole window, 0 ms at 100 µs. The 200–500 µs switching bin is empty. PD2 persistence on this run shows the same long low and slow rise, plus one narrow tick on that rise. Do not add dead time. Do not raise 380 V or 2400 Hz. Do not convert CPM to dose.
- SI-29BG scope-session window finished on 2026-10-05. `make read-gm-test` returned GM_TEST_EXCESSIVE_FAST_PULSES, EEPROM COMPLETE. 600 s, 6397 measurement pulses, 639.7 CPM, min CPS 0, max CPS 43, minimum interval 146 µs. Exclusive bins 0 / 0 / 296 / 50 / 72 / 144 / 428 / 608 / 4798. The first 16 gaps below 500 µs are 155, 167, 162, 159, 168, 151, 157, 152, 147, 167, 146, 161, 164, 154, 151, 154 µs, all inside 146–168 µs. HV 374–383 V at ADC 873–894, final count 885, pulse 79–83 µs, 0 ms at 100 µs. This window includes the source, so min CPS 0 is the time the source was away and max CPS 43 is the source against the tube. It is not a background sample. The background window that followed is the bullet above. Do not add dead time.
- SI-29BG PD2 persistence, 2026-10-05, Rigol MSO5104, 50 µs/div, falling trigger at 1.48 V, delay 200.5 µs. Three captures at the same settings. Moderate source and background: one active-low pulse, low until roughly 150–200 µs, slow rise spread over a few tens of microseconds, faint narrow ticks just after the rise, no second full-height pulse. Source against the tube: the triggered pulse has that same recovery, and later full pulses appear to the right of it. Those later pulses are copies of the first (long low, slow rise) and they are not locked to one delay, so they are the next real counts at a high rate. The phase-locked feature is still the recovery. The stored 151–185 µs intervals line up with that recovery. Do not add dead time from these pictures. The EEPROM record for this session is the bullet above.
- SI-29BG PD2 single-shot captures on 2026-10-05 show one low pulse per trigger. Idle is 3.36 V and the low is 0 V. The rise back to high is monotonic, about 30–40 µs, with no second crossing. A 200 µs/div capture stays high for more than 1 ms after that rise. No second falling edge was in those single shots. Persistence captures the same day are the bullets above. Do not ISP-read until the LED has been steady.
- SI-29BG scope transport image was re-armed on 2026-10-05 after the 229 V timeout. The programmer reset left it ARMED with HV off. The next real power-on starts the 5 s delay. Use the supply that previously held 380 V near 80 µs; scope only GM_PULSE / PD2 to GND. Do not flash or ISP-read before the scope run.
- SI-29BG scope transport run aborted on 2026-10-05. `make read-gm-test` returned GM_TEST_HV_TIMEOUT, EEPROM ABORTED. The window never opened. Total pulses 10, measurement pulses 0. HV final/min/max 229 V, ADC 534/534/534, pulse width 100 µs on the cap, time at 100 µs not applicable. The converter was pinned at the 100 µs cap and did not enter the 380 V settle band. High voltage is off. Do not raise the setpoint. Do not arm again until the board supply at the scope can hold the earlier 380 V / ~80 µs point. The four-blink LED is this abort.
- SI-29BG source run passed on 2026-10-05. `make read-gm-test` returned GM_TEST_EXCESSIVE_FAST_PULSES, EEPROM COMPLETE. The window finished. 7317 measurement pulses, 731.7 CPM, one extra edge before the window, min CPS 1, max CPS 25, minimum interval 145 µs. Exclusive bins 0 / 0 / 510 / 27 / 34 / 75 / 210 / 346 / 6114. The first 16 gaps below 500 µs are 154, 170, 381, 167, 157, 160, 153, 155, 164, 159, 160, 163, 154, 166, 234, 159 µs. Fourteen of those sixteen are 153–170 µs. The 200–500 µs bin holds 27 gaps, which matches ordinary spacing at this rate. HV 376–383 V at ADC 878–893, final count 888, pulse 79–81 µs, 0 ms at 100 µs. Blanking stayed 0. The fast-pulse flag is the background threshold of 25 gaps under 1 ms; this source run has 571 such gaps and still completed. Do not add dead time. Do not raise 380 V or 2400 Hz. No PD2 scope capture was recorded with this read.
- SI-29BG close-interval run passed on 2026-10-02. `make read-gm-test` returned GM_TEST_OK, EEPROM COMPLETE. 112 measurement pulses, 11.2 CPM, min CPS 0, max CPS 3, minimum interval 151 µs. Exclusive bins 0 / 0 / 10 / 0 / 0 / 0 / 0 / 0 / 101. All 10 gaps below 500 µs were stored: 177, 151, 182, 160, 185, 161, 172, 183, 173, 164 µs. Sorted, they occupy 151–185 µs. The 200–500 µs switching bin is empty. HV 377–381 V at ADC 879–888, final count 886, pulse 79–80 µs, 0 ms at 100 µs. Blanking stayed 0. Do not add dead time. Do not raise 380 V or 2400 Hz. No PD2 scope capture was recorded with this read. Do not convert CPM to dose until a sensitivity coefficient is chosen. The SBM-20 has not arrived. A reset must not start HV again.
- SI-29BG 1 µs inter-arrival run passed on 2026-10-02. `make read-gm-test` returned GM_TEST_OK, EEPROM COMPLETE. 85 measurement pulses, 8.5 CPM, min CPS 0, max CPS 2, minimum interval 151 µs. Exclusive bins: 0 / 0 / 6 / 0 / 0 / 0 / 0 / 0 / 78. All six close gaps are in 151–199 µs. The 200–500 µs bin, where 417 µs switching would land, is empty. HV 377–381 V at ADC 879–888, final count 887, pulse 79–80 µs, 0 ms at 100 µs. Do not raise 380 V or 2400 Hz. Do not add dead time from this record. Do not convert CPM to dose until a sensitivity coefficient is chosen. The SBM-20 has not arrived. A reset must not start HV again.
- SI-29BG 10-minute background run passed on 2026-10-02. `make read-gm-test` returned GM_TEST_OK, EEPROM COMPLETE. 112 measurement pulses, 11.2 CPM, min CPS 0, max CPS 6, six same-tick gaps and two 1 ms gaps, HV 378–380 V at ADC 881–886, pulse width 80 µs, 0 ms at 100 µs. The 60 s path test the same day was 7 CPM with one same-tick pair. Do not raise 380 V or 2400 Hz. Do not exceed 100 µs. Do not add software dead time for the close pairs. Do not convert CPM to dose until a sensitivity coefficient is chosen. The SBM-20 has not arrived. A reset must not start HV again.
- HV characterization is closed on 2026-10-02. The frozen limits are the nominal tube target of 380 V, a nominal frequency of about 2400–2500 Hz, an absolute pulse cap of 100 µs, and a production HV abort around 400 V (932 counts). The chosen SI-29BG point inside that band is 380 V at 2400 Hz. The 380 V / 2500 Hz production hold passed on 2026-10-02. The Q1-diode peak measured 427.4 V with the probe attached. Thermals were OK. A meter on the HV output loads the converter and latches the hold off.
- SBM-20 factor work is merged to `dev`. The GitHub remote is `CZ-Infokom/GeigerNode`. A root README is in the tree. Adversarial review for the first `master` tag was a same-model fallback: GPT/Gemini/Opus were unavailable; Grok plus three inherit-critic passes found no hard blockers. Local `main` is the old Agent piping commit and is not the release branch. The JNA DR-M3 comparison has not been run. I2C was not re-read after the 2026-11-05 flash; `0x03` and `0x41 0x00` are the post-erase defaults.
- Phase 0 host toolchain is recorded in `firmware/bringup/README.md`. Compiler is `/opt/avr8-gnu-toolchain-4.0.0` (`avr-gcc` `AVR_8_bit_GNU_Toolchain_4.0.0_52`, GCC 15.1.0). `avrdude` is system 8.1 at `/usr/bin/avrdude`. `-mmcu=atmega328pb` works.
- Section 33 skeleton is in the tree: `firmware/Makefile`, `firmware/README.md`, `firmware/bringup/README.md`, `firmware/include/board.h`, `firmware/src/main.c`. PB1 is forced low and PD7 blinks. `make flash` programs flash only.
- Host build succeeds with no warnings (`F_CPU=1000000UL`, 240 bytes text). That image was flashed and verified on 2026-10-01.
- Phase 2 has passed. Signature, fuses, flash, verify, PD7 blink, PB1 low, 3.3 V rail, supply current, no heating, and HV converter inactive are recorded in `firmware/bringup/boards/board01.txt`.
- Phase 3 fuses were written on 2026-10-01 with `make fuses` and read back as LFUSE `0xE2`, HFUSE `0xD9`, EFUSE `0xF5`. Signature remained `0x1E9516`. `make flash` still programs flash only.
- Phase 4 passed. Before the timer image, the 1 MHz blink firmware flashed at 8 Hz. After `make F_CPU=8000000UL flash` (260 bytes, verified), PD7 measured 500 Hz. The Makefile default is now `8000000UL`.
- Phase 5A passed on 2026-10-01. PD7 blinks with 500 ms on and 500 ms off, and PB1 remains low.
- Phase 5B passed on 2026-10-01. PD2 falling edges increment the counter, and the LED flickers when they arrive. The tube stayed disconnected.
- Phase 5C passed on 2026-10-01. ADC0 read raw 5 with the converter off (1 long flash, 5 short flashes). Nominal conversion is 2.15 V at the HV node; the meter earlier read 2.1 V.
- Phase 5D TWI passed on 2026-10-05. A host master sees address `0x66` and receives values.
- Phase 6/9 register bank is live. A TWI read latches the bank so `0x03`..`0x08` cannot tear. Static radiation uses `S = 137.5 impulses/µR` and the last 60 s. The first host dump returned the same two live bytes at every address; the pointer fix is waiting to flash.
- Phase 7 width sweep at 500 Hz is finished at the 100 µs cap: 133.5 V DC with the DMM connected. Earlier points: 43.7 V at 25 µs, 57.5 V at 40 µs, 105 V at 70 µs, 100.5 V at 70 µs / 800 Hz, and 119.8 V at 85 µs. Those results are not committed. 133.5 V is a loaded reading, not the unloaded ceiling. Do not disconnect the DMM and run 100 µs. The converter-off ADC LED-readout image (`HV_TEST_ENABLE` 0) was flashed and verified on 2026-10-01, 2570 bytes. OFF DMM reading is 3.0517 V, first reported as 3.03 V. The HV_ADC node measured 8 mV. Nominal divider from 3.0517 V is 7.6 mV. Complete LED groups 1, 1, 1, 5 then 1, 1, 1, 6 decode to hv_adc_raw = 4 and hv_adc_avg = 5. Nominal HV from the average is 2.15 V. The 25 µs / 500 Hz correlation reads 56.8 V on the DMM. LED groups 1, 3, 7, 2 and 1, 3, 7, 2 decode to raw 261 and average 261. The ADC pin measured 280 mV, and count 261 is 280.4 mV at a 1.100 V reference. The nominal 40 MOhm / 100 kOhm divider predicts 142 mV and about 112 V from that count, so the fitted divider is still open. The earlier 25 µs DMM reading was 43.7 V. The 70 µs / 500 Hz correlation reads 106 V on the DMM. LED groups 1, 5, 9, 5 and 1, 5, 9, 6 decode to raw 484 and average 485. The ADC pin measured 519 mV, and count 484 is 519.9 mV at a 1.100 V reference. The nominal divider predicts 264 mV and about 209 V from the average. The earlier 70 µs DMM reading was 105 V. The first 100 µs correlation aborted at count 581 because the 250 V nominal ceiling latched PB1 low. The repeat, with the 350 V nominal ceiling, reads 133.7 V on the DMM. LED groups 1, 7, 2, 1 decode to raw 610 and average 610. The ADC pin measured 651.2 mV. Count 610 is 655 mV at a 1.100 V reference, so that pair puts the reference near 1.094 V. The nominal divider predicts 333 mV and about 263 V. The earlier 100 µs DMM reading was 133.5 V. The four DMM-connected ADC rows are recorded. The divider remains 401:1. A 60 V closed-loop image is built and not flashed. The Q1 collector waveform is still open. The tube stays disconnected.

Checkpoint results:
- Host toolchain: pass. `avr-gcc` 15.1.0 accepts `atmega328pb`. avrdude 8.1 has `m328pb` and `atmelice_isp`.
- Device signature: pass. `make read-signature` on 2026-10-01 returned `0x1e,0x95,0x16` (ATmega328PB). Recorded in `firmware/bringup/boards/board01.txt`.
- Fuse bytes: pass, read only. LFUSE `0x62`, HFUSE `0xD9`, EFUSE `0xF7`. Decoded against DS40001906C as the shipping clock: internal 8 MHz RC, CKDIV8 programmed, CPU clock 1.0 MHz. ISP enabled, RESET retained, debugWIRE off, BOD off, CFD off.
- Flash and verify: pass. 240 bytes, `F_CPU=1000000UL`, 2026-10-01.
- LED on PD7: pass. Toggles every 500 ms, consistent with the 1.0 MHz clock.
- PB1 held LOW: pass. The earlier high report was measurement error. Recorded in `firmware/bringup/boards/board01.txt`.
- 3.3 V rail: pass, measured 3.3 V.
- Supply current: pass, reported ok. No unexpected heating.
- HV converter: inactive. HV side measures 2.1 V.
- Phase 2: pass.
- Phase 3 fuse write: pass. 2026-10-01 read-back LFUSE `0xE2`, HFUSE `0xD9`, EFUSE `0xF5`, signature `0x1E9516`.
- Phase 4: pass. Pre-flash blink was exactly 8 Hz on the 1 MHz-timed image. Post-flash PD7 measured 500 Hz with the Timer2 image built at `F_CPU=8000000UL`. CPU clock is 8 MHz.
- Phase 5A LED: pass. 2026-10-01, PD7 blinks 500 ms on and 500 ms off. PB1 remains low.
- Phase 5B GM pulse: pass. 2026-10-01, falling edges on PD2 are counted and the LED flickers. Tube disconnected. PB1 remains low.
- Phase 5C HV ADC: pass. 2026-10-01, raw 5 with the converter off. Nominal HV-node voltage 2.15 V against an earlier 2.1 V meter reading.
- Phase 5D TWI: pass. 2026-10-05, a host master sees address `0x66` and receives values. Exact register bytes were not recorded.
- HV characterization: closed, 2026-10-02. Nominal target 380 V. Nominal frequency about 2400–2500 Hz. Pulse cap 100 µs. Production abort around 400 V. Q1-diode peak at 380 V measured 427.4 V with the probe attached.
- Production hold: pass, 2026-10-02. 380 V at 2500 Hz. Q1-diode peak 427.4 V with the probe attached. Thermals OK. A meter on the HV output latches the hold off. Tube disconnected.
- SI-29BG 60 s pulse-path test: pass, 2026-10-02. Host image is 7382 bytes of text. `make read-gm-test`: duration finished, total 7, measurement 7, CPM 7, min CPS 0, max CPS 2, minimum interval 0 ms, one interval in each cumulative bin, HV final/min/max 379 V, ADC final 885, min 883, max 885, pulse final/min/max 80 µs, 0 ms at 100 µs, GM_TEST_OK, EEPROM COMPLETE. The unloaded 2400 Hz / 380 V hold had finished near 91 µs. This window held 80 µs and did not move. No software dead time was added.
- SI-29BG 10-minute background: pass, 2026-10-02. Image 7524 bytes. `make read-gm-test`: 600 s finished, total 112, measurement 112, CPM 11.2, min CPS 0, max CPS 6, minimum interval 0 ms, cumulative bins 6 / 8 / 8 / 8, HV final 379 V, min 378 V, max 380 V, ADC final 885, min 881, max 886, pulse 80 µs throughout, 0 ms at 100 µs, GM_TEST_OK, EEPROM COMPLETE. The close pairs were counted. They stayed under the excessive-fast flag.
- SI-29BG 1 µs inter-arrival: pass, 2026-10-02. Image 8160 bytes. `make read-gm-test`: 600 s finished, total 85, measurement 85, CPM 8.5, min CPS 0, max CPS 2, minimum interval 151 µs, exclusive bins 0 / 0 / 6 / 0 / 0 / 0 / 0 / 0 / 78 for <50 µs through >=10 ms. Sum of bins is 84, one less than the pulse count. HV final 380 V, min 377 V, max 381 V, ADC final 887, min 879, max 888, pulse final 80 µs, min 79 µs, max 80 µs, 0 ms at 100 µs, GM_TEST_OK, EEPROM COMPLETE. The close gaps sit in 151–199 µs. Converter coupling at 417 µs is not present.
- SI-29BG 10-minute background after the scope session: pass, 2026-10-05. Same transport image. `make read-gm-test`: 600 s finished, total 76, measurement 75, CPM 7.5, min CPS 0, max CPS 2, minimum interval 156 µs, exclusive bins 0 / 0 / 1 / 0 / 0 / 0 / 0 / 0 / 73. Sum of bins is 74. The one gap below 500 µs is 156 µs. HV final 379 V displayed, min 378 V, max 380 V, ADC final 885, min 882, max 887, pulse 80 / 80 / 80 µs, 0 ms at 100 µs, GM_TEST_OK, EEPROM COMPLETE. A steady 0.125 counts/s expects about 0.002 gaps under 200 µs; one was observed, at 156 µs. The 417 µs switching bin is empty.
- SI-29BG scope-session window: pass, 2026-10-05. Same transport image. `make read-gm-test`: 600 s finished, total 6397, measurement 6397, CPM 639.7, min CPS 0, max CPS 43, minimum interval 146 µs, exclusive bins 0 / 0 / 296 / 50 / 72 / 144 / 428 / 608 / 4798. Sum of bins is 6396. Close log kept the first 16 of 346 gaps below 500 µs, and all 16 are 146–168 µs. HV final 379 V, min 374 V, max 383 V, ADC final 885, min 873, max 894, pulse 80 / 79 / 83 µs, 0 ms at 100 µs, GM_TEST_EXCESSIVE_FAST_PULSES, EEPROM COMPLETE. The source was in the window. A constant 10.7 counts/s would put about 14 gaps under 200 µs; 296 were observed, still the recovery companion. Min ADC 873 is the bottom of the ±5 V band.
- SI-29BG PD2 persistence: recorded, 2026-10-05. Same 50 µs/div, 1.48 V falling trigger, 200.5 µs delay. Background and a moderate source show one pulse and a recovery at 150–200 µs, with faint ticks after the rise and no second full pulse. With the source against the tube the triggered pulse keeps that recovery, and later full pulses appear at irregular delays to the right. Those later pulses are the next counts. Dead time stays off.
- SI-29BG source run: pass, 2026-10-05. Same 8338-byte image. `make read-gm-test`: 600 s finished, total 7318, measurement 7317, CPM 731.7, min CPS 1, max CPS 25, minimum interval 145 µs, exclusive bins 0 / 0 / 510 / 27 / 34 / 75 / 210 / 346 / 6114. Sum of bins is 7316. Close log kept the first 16 of 537 gaps below 500 µs: 154, 170, 381, 167, 157, 160, 153, 155, 164, 159, 160, 163, 154, 166, 234, 159 µs. Fourteen are 153–170 µs. HV final 381 V, min 376 V, max 383 V, ADC final 888, min 878, max 893, pulse 80 / 79 / 81 µs, 0 ms at 100 µs, GM_TEST_EXCESSIVE_FAST_PULSES, EEPROM COMPLETE. Blanking 0. About 7% of edges are the 100–200 µs companion, the same fraction as background. The 27 gaps in 200–500 µs match the random expectation at 12 counts/s.
- SI-29BG close-interval log: pass, 2026-10-02. Image 8338 bytes. `make read-gm-test`: 600 s finished, total 112, measurement 112, CPM 11.2, min CPS 0, max CPS 3, minimum interval 151 µs, exclusive bins 0 / 0 / 10 / 0 / 0 / 0 / 0 / 0 / 101. Close log, in order: 177, 151, 182, 160, 185, 161, 172, 183, 173, 164 µs. Ten of ten gaps below 500 µs. Sorted range 151–185 µs, mean about 171 µs. HV final 380 V, min 377 V, max 381 V, ADC final 886, min 879, max 888, pulse 80 / 79 / 80 µs, 0 ms at 100 µs, GM_TEST_OK, EEPROM COMPLETE. Blanking 0. The delay is repeatable and is not 417 µs switching.
- Phase 7 HV open-loop: 25 µs PB1 checks pass. Scope: 499.44 Hz, 1.2563% duty, 25.155 µs high, 2.0022 ms period. HV output 43.7 V DC. 40 µs: 57.5 V DC. 70 µs at 500 Hz: 105 V DC. 70 µs at 800 Hz: 100.5 V DC. 85 µs at 500 Hz: 119.8 V DC. 100 µs cap at 500 Hz: 133.5 V DC. Width sweep finished. Do not exceed 100 µs. ADC correlation: OFF is 3.0517 V, HV_ADC 8 mV, raw 4, average 5. 25 µs is 56.8 V, HV_ADC 280 mV, raw 261, average 261. 70 µs is 106 V, HV_ADC 519 mV, raw 484, average 485. 100 µs is 133.7 V, HV_ADC 651.2 mV, raw 610, average 610, after a first attempt latched off at count 581. The 60 V closed-loop result is HV_TEST_OK: final ADC 143, max ADC 168, final 9 µs, max 20 µs, final estimate 61 V, max estimate 71 V. The 100 V result is HV_TEST_OK: final ADC 235, max ADC 259, final 21 µs, max 35 µs, final estimate 100 V, max estimate 111 V. The 150 V result is HV_TEST_OK: final ADC 348, max ADC 376, final 41 µs, max 56 µs, final estimate 149 V, max estimate 160 V. The 200 V result is HV_TEST_OK: final ADC 463, max ADC 488, final 65 µs, max 78 µs, final estimate 198 V, max estimate 209 V. The 250 V result is HV_TEST_OK: final ADC 580, max ADC 596, final 92 µs, max 100 µs, final estimate 248 V, max estimate 255 V. The frequency series on 2026-10-01 is COMPLETE: 275 V at 600 Hz is HV_TEST_OK, final ADC 643, max 648, final 97 µs, max 100 µs, 180 ms at the cap, final estimate 275 V. 300 V at 600 Hz is HV_TEST_SATURATED at 100 µs, final ADC 655, about 281 V. 300 V at 750 Hz is HV_TEST_OK, final ADC 697, final 97 µs, max 100 µs, final estimate 299 V. 300 V at 1000 Hz is HV_TEST_OK, final ADC 698, final 83 µs, max 89 µs, final estimate 299 V, and it did not reach the cap. The upper-300 ladder at 1000 Hz is COMPLETE: 310 V final ADC 724, final 88 µs, max 94 µs; 320 V final ADC 745, final 92 µs, max 98 µs; 330 V final ADC 770, final 97 µs, max 100 µs, 100 ms at the cap, final estimate 330 V, max estimate 333 V. All three are HV_TEST_OK. Later series did run 340 V and above. Q1 at 330 V measured about 360 V. Q1 at the 380 V / 1500 Hz point measured 411 V.

Decisions that must survive across sessions:
- Version tags publish GitHub releases from `.github/workflows/firmware.yml`. `vMAJOR.MINOR.PATCH` is a release. Any SemVer pre-release suffix (`-beta`, `-rc`, `-pre`, `-alpha`, and every other `-identifier`) is a GitHub pre-release and is not marked Latest. Release assets are the native and RadSens HEX files and their Flipper `.avr` descriptors. Those descriptors keep LFUSE `E2`, HFUSE `D9`, EFUSE `F5`, and lock `FF`. The workflow does not call avrdude. Do not change those bytes. Do not write fuses from CI.
- Build with `/opt/avr8-gnu-toolchain-4.0.0/bin/avr-gcc`, `avr-objcopy`, and `avr-size`. The `avr-gcc` 12.1.0 on `PATH` is a different install.
- `avrdude` stays `/usr/bin/avrdude` 8.1. It is not in the toolchain tree.
- Saved fuses select the internal 8 MHz RC with CKDIV8 unprogrammed. The measured PD7 frequency is 500 Hz, and the Makefile default is `F_CPU=8000000UL`.
- The HV divider is 40 MOhm / 100 kOhm, ratio 401:1. Do not infer a different ratio from DMM readings taken at different times.
- The temporary bring-up ADC reference is 1095 mV. It is not the final calibration. Closed-loop counts use divisor 1023.
- Characterization limits are frozen as of 2026-10-02. Nominal tube target is 380 V. Nominal frequency is about 2400–2500 Hz. The absolute pulse cap is 100 µs. The production HV abort is around 400 V, which is 932 counts with the 401:1 divider, 1095 mV reference, and divisor 1023. That abort is not the 995-count characterization ceiling. The Q1-diode peak at 380 V measured 427.4 V with the probe attached. Do not raise the target, the frequency band, or the pulse cap without a new decision. Do not change fuses.
- Tube sensitivity constants remain configurable and separate from raw counting. The fitted tube is an SBM-20. Reset publishes its Cs-137 datasheet midpoint, 65 impulses/µR, from `gm_tube_active`. The SI-29BG factory value remains 137.5 impulses/µR, register 138, and is not the live default. A host may write 0..510; the value is stored at EEPROM 960. `make flash` chip-erases that record and restores 65. The RadSens-module Ra-226 value 105 is not loaded. Pulse counting must not scale by S. The JNA DR-M3 comparison has not been run and does not replace 65 until a measurement is accepted. The mantle is not a calibrated source.
- SI-29BG operating point is 380 V at 2400 Hz. Every falling edge is counted. Blanking is 0. The current image waits 500 ms after reset, with the LED on, then starts HV if register `0x11` is 1. A host may write `0` or `1` to stop or start the generator after that wait. An operational fault retries four times (30 s, 2 min, 10 min off) and then latches. An illegal pulse or rate latches immediately. A write of `1` after give-up starts a new budget. The default address is `0x66`; a host may store another address in `0x03`..`0x77`. There is no arm word. Do not add a dead time for the close pairs. Do not raise the setpoint.
- The first closed-loop image targets 60 V at 500 Hz, starts at 10 µs, and hard-aborts at ADC count 580. The pulse cap remains 100 µs and the run remains 10 s. The 60 V result on 2026-10-01 is HV_TEST_OK: final ADC 143, max ADC 168, final pulse 9 µs, max pulse 20 µs, final estimate 61 V, max estimate 71 V. The 100 V result the same day is HV_TEST_OK: final ADC 235, max ADC 259, final pulse 21 µs, max pulse 35 µs, final estimate 100 V, max estimate 111 V. The 150 V result is HV_TEST_OK: final ADC 348, max ADC 376, final pulse 41 µs, max pulse 56 µs, final estimate 149 V, max estimate 160 V. The 200 V result is HV_TEST_OK: final ADC 463, max ADC 488, final pulse 65 µs, max pulse 78 µs, final estimate 198 V, max estimate 209 V. The abort is now 815 counts, about 350 V. The 250 V result is HV_TEST_OK: final ADC 580, max ADC 596, final pulse 92 µs, max pulse 100 µs, final estimate 248 V, max estimate 255 V. The climb used the 100 µs cap. The later frequency series did run 300 V at 600, 750, and 1000 Hz. It did not run 300 V at 500 Hz. The upper-300 ladder at 1000 Hz is also COMPLETE: 310 V, 320 V, and 330 V are HV_TEST_OK. 330 V held 97 µs and touched 100 µs. Q1 collector at that 330 V point measured about 360 V. The 1200 Hz series is COMPLETE. 340 V is HV_TEST_OK at a 99 µs hold. 350 V, 360 V, and 380 V all saturate at 100 µs and about 342 V. One Q1 collector reading during that series was 383.77 V. The later series is also COMPLETE: 360 V at 1400 Hz held 93 µs, and 380 V at 1500 Hz held 99 µs. 1600 Hz was not run. Q1 at the 380 V / 1500 Hz point measured 411 V. The 2000 Hz ladder is COMPLETE. 350 V through 380 V held below the 100 µs cap. 390 V sat at 100 µs and about 389 V and was still HV_TEST_OK. 400 V saturated at the same ceiling, about 389 V. Scope peaks from GND to the Q1-diode net were 395 V, 407 V, 415 V, 427 V, 439 V, and 439 V. The 3.3 V rail stayed stable. Ringing was present, well behaved, and fell off fast. Temperature was OK. The 380 V sweep from 2000 Hz to 2500 Hz is COMPLETE. Holds were 96, 95, 94, 92, 91, and 90 µs. Q1-diode peaks were 423 V, then 427 V. The 2500 Hz ladder from 350 V to 400 V is COMPLETE. 400 V held 97 µs, peak reservoir 403 V. Q1-diode peaks were 391 V, 403 V, 415 V, 427 V, 435 V, and 447 V. The 400 V sweep from 2500 Hz to 3000 Hz is COMPLETE. Holds were 85, 84, 95, 94, 93, and 92 µs. All six are HV_TEST_OK. The Q1-diode peak was 447 V on every step. Ringing subsided well in time. The 3.3 V rail stayed stable. Temperature was OK.

Open blockers:
- Hardware TWI0 RadSens image is flashed and bus-checked, 2026-11-06, 8724 bytes, firmware `0x04`. ESP32-C3 sees `7D 04`, `41 00`, address `0x66`, pulse clear on `0x09`, and BME680 `0x61`. Bit-bang fallback is `fallback/bitbang-i2c`. The JNA DR-M3 comparison has not been run. Do not put a meter on the HV output. Do not raise the target. Stay clear of the HV section: the LED is on for 500 ms, then 380 V starts.
- SBM-20 image is flashed and verified, 2026-11-05, 8902 bytes. Firmware `0x03`, sensitivity 65 after the chip erase. The JNA DR-M3 comparison has not been run. Do not put a meter on the HV output. Do not add dead time. Do not raise the target. Stay clear of the HV section: the LED is on for 500 ms, then 380 V starts. Operational faults retry before the four-blink give-up.
- The 100 µs pulse-width cap stays. The 60 V through 250 V closed-loop results are HV_TEST_OK. The frequency series is COMPLETE in EEPROM. 600 Hz regulates 275 V but saturates at 300 V near 281 V. 750 Hz reaches 300 V with a 97 µs hold. 1000 Hz holds 300 V at 83 µs. The same frequency holds 310 V at 88 µs, 320 V at 92 µs, and 330 V at 97 µs. The 330 V climb touched the 100 µs cap. The earlier abort of 815 counts applied through the 1000 Hz ladder. Q1 collector at about 330 V measured about 360 V on the STR1550 (VCEO 500 V), so the margin at that point is about 140 V. 360 V at 1400 Hz and 380 V at 1500 Hz are HV_TEST_OK. 1600 Hz was not needed. The pulse cap stays 100 µs. Q1 at the 380 V / 1500 Hz point measured 411 V. The 2000 Hz ladder is COMPLETE in EEPROM. 380 V held 96 µs. 390 V and 400 V both sit at about 389 V and 100 µs. 400 V is HV_TEST_SATURATED. The unloaded ceiling at 2000 Hz and 100 µs is about 389 V. The pulse cap stays 100 µs. The hard abort stays 995 counts. Scope peaks from GND to the Q1-diode net were 395 V, 407 V, 415 V, 427 V, 439 V, and 439 V. The highest is 11 V under the 450 V stop. The 3.3 V rail stayed stable. Ringing was present, well behaved, and fell off fast. Temperature was OK. The 380 V sweep from 2000 Hz to 2500 Hz is COMPLETE. Holds were 96, 95, 94, 92, 91, and 90 µs. All six are HV_TEST_OK. The 2200 Hz step touched 100 µs for 260 ms and peaked near 391 V, then settled at 94 µs. Q1-diode peaks on that sweep were 423 V at 2000 Hz and 427 V from 2100 Hz through 2500 Hz. The 2500 Hz ladder from 350 V to 400 V is COMPLETE and every step is HV_TEST_OK. 400 V held 97 µs with a 99 µs peak and a 403 V reservoir peak. Q1-diode peaks on that ladder were 391 V, 403 V, 415 V, 427 V, 435 V, and 447 V. The 3.3 V rail stayed stable. Ringing was present, well behaved, and fell off fast. Temperature was OK. 447 V is 3 V under the 450 V stop. The 400 V sweep from 2500 Hz to 3000 Hz is COMPLETE. Holds were 85, 84, 95, 94, 93, and 92 µs. All six are HV_TEST_OK. The Q1-diode peak was 447 V on every step. Ringing subsided well in time. The 3.3 V rail stayed stable. Temperature was OK. Characterization is frozen: nominal target 380 V, nominal frequency about 2400–2500 Hz, pulse cap 100 µs, production abort around 400 V. The 995-count abort was characterization only. Do not change fuses.

======================================================================
1. HARDWARE
======================================================================

MCU:
- Microchip ATmega328PB-AU
- TQFP-32
- Nominal MCU supply: 3.3 V
- Final intended CPU clock: internal 8 MHz RC oscillator
- No external crystal
- No bootloader
- Programming: AVR ISP
- Programmer: Atmel-ICE

IMPORTANT:
- This is ATmega328PB, NOT ATmega328P.
- Do not substitute ATmega328P device definitions.
- Check all registers, interrupt vectors, fuse definitions, and peripheral names against ATmega328PB support in the installed toolchain and datasheet.

Programming connection:
- MOSI0
- MISO0
- SCK0
- RESET
- VCC sense
- GND

The PCB is externally powered.
Do NOT assume Atmel-ICE powers the target.

======================================================================
2. CURRENT BOARD PIN ASSIGNMENT
======================================================================

ATmega328PB:

PB1 / OC1A:
    HV_SW
    Drives the high-voltage converter transistor.

PC0 / ADC0:
    HV_ADC
    High-voltage feedback measurement.

PD2 / INT0:
    GM_PULSE
    Active-low Geiger pulse input.

PD7:
    LED

PC4 / SDA / TWI0:
    SDA

PC5 / SCL / TWI0:
    SCL

PD3:
    UNUSED / SPARE GPIO
    Do not initialize or depend on it.

SPI0 / ISP:
    MOSI0
    MISO0
    SCK0
    RESET

THERE IS NO BUZZER ON THE CURRENT BOARD REVISION.

Do not create:
- buzzer.c
- buzzer.h
- buzzer tests
- OC2B buzzer configuration
- PD3 buzzer handling

Timer2 is currently free.

======================================================================
3. POWER ARCHITECTURE
======================================================================

External Grove VCC may be approximately:
- 3.3 V
- 5 V

The board uses a 3.3 V LDO for the internal rail.

Internal 3.3 V powers:
- ATmega328PB
- BME680
- I2C low-voltage side
- HV converter input

The board contains an onboard BME680.

There are BSS138 bidirectional I2C level shifters between:

    SDA_HOST / SCL_HOST
            |
         BSS138
            |
       SDA / SCL

Internal I2C pull-ups:
- 4.7 kOhm
- to +3.3 V

HOST-side pull-ups may be supplied by the Seeed Solar Node.

The onboard BME680 can be disconnected from the internal SDA/SCL bus using two normally-closed solder jumpers.

The ATmega firmware does NOT need to control the BME680.

The external Meshtastic host can access:
- GeigerNode ATmega at 0x66
- onboard BME680 directly

======================================================================
4. HIGH-VOLTAGE SAFETY
======================================================================

THIS BOARD GENERATES APPROXIMATELY 400 V.

Treat the HV subsystem as safety-critical.

HV_SW = PB1 / OC1A.

During initial bring-up:

    HV MUST NEVER BE ENABLED.

Requirements:

- PB1 must be configured as output LOW as the first hardware action in firmware.
- Timer1 PWM must remain disabled.
- OC1A output mode must remain disconnected.
- No code may toggle PB1 during Phase 1.
- No generic GPIO test may touch PB1.
- No peripheral initialization may take ownership of PB1 accidentally.

There is hardware biasing intended to keep the transistor OFF, but firmware must still explicitly maintain HV_SW LOW.

Never implement "test all GPIO pins" code that includes PB1.

Later HV firmware must independently enforce:
- maximum pulse width
- maximum repetition frequency
- maximum duty cycle
- maximum HV ADC reading
- startup timeout
- fault state
- watchdog-safe shutdown
- command-off state
- reset-safe state

A feedback algorithm must NEVER be the only thing preventing continuous Q1 drive.

======================================================================
5. GM INPUT
======================================================================

GM_PULSE:
- PD2 / INT0
- active LOW
- falling-edge interrupt

Later implementation:

ISR:
    increment pulse counter
    return

ISR must NOT:
- calculate CPM
- calculate radiation
- blink LEDs
- perform I2C
- delay
- print/debug
- perform floating-point math

Use a volatile counter.

Any multi-byte counter accessed from both main and ISR must be accessed atomically.

======================================================================
6. HV ADC
======================================================================

HV_ADC:
- PC0 / ADC0

HV feedback divider is approximately:

    HV
     |
    40 MOhm
     |
    HV_ADC
     |
    100 kOhm
     |
    GND

At approximately 400 V:
    HV_ADC is approximately 1.0 V

Intended ADC reference:
    internal nominal ~1.1 V reference

ADC calibration must eventually use measured hardware values rather than assuming the internal reference is exactly 1.100 V.

During initial ADC testing:

    HV converter remains OFF.

======================================================================
7. I2C / RADSENS COMPATIBILITY
======================================================================

The ATmega328PB operates as an I2C/TWI SLAVE.

Target I2C address:

    0x66

The firmware must eventually emulate enough of a ClimateGuard RadSens interface for Meshtastic.

Minimum required functionality:

Register 0x00:
    return 0x7D

Registers 0x06..0x08:
    24-bit big-endian static radiation value

Unit:
    0.1 uR/h

Protocol behavior must support:

1. master START
2. slave address + WRITE
3. register pointer byte
4. repeated START
5. slave address + READ
6. sequential register reads
7. STOP

Do not assume every master inserts STOP between register selection and read.

Future extended register map:

0x00       device ID
0x01       firmware version
0x03..05   dynamic radiation
0x06..08   static radiation
0x09..0A   pulse count
0x0C       low-power control
0x10       address
0x11       HV enable
0x12..13   sensitivity
0x14       LED control

Do not implement the full map during first bring-up.

======================================================================
8. TOOLCHAIN
======================================================================

Use:

- Microchip AVR 8-bit GNU Toolchain 4.0.0
- avr-gcc
- avr-libc
- avr-objcopy
- avr-size
- GNU Make
- avrdude
- Atmel-ICE ISP

NO:
- Arduino
- PlatformIO
- Arduino core
- MiniCore
- bootloader
- vendor HAL
- dynamic framework initialization

Programming transport:

    Atmel-ICE ISP

Compiler MCU:

    atmega328pb

avrdude MCU identifier is expected to be:

    m328pb

Programmer identifier is expected to be:

    atmelice_isp

If the locally installed avrdude uses different identifiers:
- inspect avrdude's supported devices/programmers
- report the discrepancy
- do NOT silently substitute ATmega328P.

======================================================================
9. VERY IMPORTANT FUSE SAFETY POLICY
======================================================================

!!!!!!!!!!!!!!!!!!!!!!!!!!!!!!!!!!!!!!!!!!!!!!!!!!!!!!!!!!!!!!!!!!!!!!
FUSE PROGRAMMING WARNING
!!!!!!!!!!!!!!!!!!!!!!!!!!!!!!!!!!!!!!!!!!!!!!!!!!!!!!!!!!!!!!!!!!!!!!

DO NOT WRITE ANY FUSES DURING INITIAL BRING-UP.

DO NOT GUESS FUSE BYTES.

DO NOT COPY ATmega328P FUSE VALUES FROM INTERNET EXAMPLES.

DO NOT HAVE "make flash" MODIFY FUSES.

DO NOT HAVE ANY NORMAL BUILD OR PROGRAMMING COMMAND MODIFY FUSES.

DO NOT AUTOMATICALLY EXECUTE FUSE PROGRAMMING COMMANDS.

Before ANY fuse write:

1. Read the existing device signature.
2. Read LFUSE.
3. Read HFUSE.
4. Read EFUSE.
5. Save the original values.
6. Decode the original values against the ATmega328PB datasheet.
7. Determine the actual current clock source.
8. Determine whether CKDIV8 is enabled.
9. Present proposed new values.
10. Decode EVERY relevant proposed bit.
11. Have a human explicitly approve the values.
12. Only then may a separate manual programming command be prepared.

Critical fuse bits include, but are not limited to:

- CKDIV8
- CKOUT
- CKSEL
- SUT
- SPIEN
- DWEN
- RSTDISBL
- WDTON
- EESAVE
- BOOTSZ
- BOOTRST
- BODLEVEL

EXTRA WARNING:

SPIEN and RSTDISBL affect ISP accessibility.

Incorrect values can make the MCU inaccessible using the normal Atmel-ICE ISP connection.

Incorrect CKSEL settings can also make the MCU appear dead because it may expect an external clock source.

Do not change:
- SPIEN
- RSTDISBL
- DWEN

without a very specific reason and explicit human authorization.

For this project:
- ISP must remain enabled
- RESET must remain RESET
- debugWIRE must remain disabled
- internal RC oscillator must ultimately be used

The final target is:

    internal 8 MHz oscillator
    CKDIV8 disabled

BUT:

DO NOT ASSUME THE MCU CURRENTLY RUNS AT 8 MHz.

Factory/new MCU configuration may have CKDIV8 enabled.

Therefore the initial firmware's timing must be based on the ACTUAL fuse state discovered during bring-up.

Do not program final clock fuses merely because the Makefile says F_CPU=8000000.

F_CPU is a compiler assumption.
Fuse bits determine the actual hardware clock.

Those two values must agree.

======================================================================
10. REPOSITORY STRUCTURE
======================================================================

Create:

firmware/
    Makefile
    README.md

    include/
        board.h
        gpio.h
        adc.h
        gm_counter.h
        twi_slave.h
        radsens.h
        hv.h
        watchdog.h

    src/
        main.c
        gpio.c
        adc.c
        gm_counter.c
        twi_slave.c
        radsens.c
        hv.c
        watchdog.c

    bringup/
        README.md
        boards/
            .gitkeep

Do not create buzzer files.

For the first task only these need real implementation:

    Makefile
    README.md
    bringup/README.md
    include/board.h
    src/main.c

Other modules may be absent or empty placeholders.

Prefer NOT creating unused placeholders unless they improve repository organization.

======================================================================
11. MAKEFILE
======================================================================

Use a readable hand-written Makefile.

Expected variables:

    TARGET := geigernode
    MCU := atmega328pb
    AVRDUDE_MCU := m328pb

    CC := avr-gcc
    OBJCOPY := avr-objcopy
    SIZE := avr-size
    AVRDUDE := avrdude

    PROGRAMMER := atmelice_isp
    PORT := usb

F_CPU must NOT initially be blindly fixed to 8 MHz.

Provide an explicit Make variable, for example:

    F_CPU ?= 1000000UL

but clearly document that its value MUST be changed to match the fuse-derived actual CPU clock.

Alternatively require:

    make F_CPU=1000000UL

or

    make F_CPU=8000000UL

Do not silently hide this choice.

After final fuse configuration is approved and installed, the project can default to:

    F_CPU := 8000000UL

Recommended flags:

    -mmcu=$(MCU)
    -DF_CPU=$(F_CPU)
    -Os
    -std=gnu11
    -Wall
    -Wextra
    -Wshadow
    -Wundef
    -ffunction-sections
    -fdata-sections

Linker:

    -mmcu=$(MCU)
    -Wl,--gc-sections

Do not add complex optimization flags during first bring-up.

Required targets:

    make
    make clean
    make size
    make flash
    make verify
    make read-signature
    make read-fuses
    make toolchain-info

Optional useful target:

    make disasm

which creates a human-readable AVR disassembly.

======================================================================
12. MAKEFILE FUSE PROTECTION
======================================================================

`make read-fuses` only reads.

`make fuses` may write only the Phase 3 bytes approved on 2026-10-01:

    LFUSE = 0xE2
    HFUSE = 0xD9
    EFUSE = 0xF5

It must not program flash. Any other fuse value needs a new decode and a new explicit approval before the Makefile changes.

Example semantics:

    avrdude \
        -p $(AVRDUDE_MCU) \
        -c $(PROGRAMMER) \
        -P $(PORT) \
        -U lfuse:r:-:h \
        -U hfuse:r:-:h \
        -U efuse:r:-:h

Never combine fuse operations with flash programming.

======================================================================
13. PHASE 0 — TOOLCHAIN VALIDATION
======================================================================

Before compiling firmware, document how to perform:

    avr-gcc --version
    avr-objcopy --version
    avr-size --version
    avrdude -v

Verify that avr-gcc supports:

    -mmcu=atmega328pb

Example test:

    echo | avr-gcc -mmcu=atmega328pb -dM -E -

Verify Atmel-ICE communication.

Read the device signature.

Do NOT write flash yet if the device signature does not match ATmega328PB.

Read all fuse bytes.

Record:

- device signature
- LFUSE
- HFUSE
- EFUSE
- avrdude version
- avr-gcc version
- board identifier / serial if available
- measured VCC

Suggested bring-up record:

    bringup/boards/board01.txt

Do not modify fuse values.

======================================================================
14. PHASE 1 — PHYSICAL POWER CHECK
======================================================================

Before firmware programming:

1. Visual inspection.
2. Check for solder bridges.
3. Check ATmega orientation.
4. Check regulator orientation.
5. Check Q1 / D1 orientation.
6. Check 3.3 V to GND resistance.
7. Check raw VCC to GND resistance.
8. Check ISP continuity.
9. Power board from a current-limited bench supply.
10. Verify approximately 3.3 V regulator output.
11. Verify ATmega VCC and AVCC.
12. Verify BME680 supply.
13. Check that no component heats unexpectedly.
14. Check PB1 / HV_SW is not being driven.

HV remains disabled.

Do not install or energize the HV section merely to test MCU firmware.

======================================================================
15. PHASE 2 — MINIMAL MCU SANITY FIRMWARE
======================================================================

Implement the smallest useful firmware.

main() must begin with:

1. PB1 output LOW
2. LED PD7 output configuration

Conceptually:

    int main(void)
    {
        /* Safety first: HV converter OFF */
        PORTB &= ~_BV(PORTB1);
        DDRB  |=  _BV(DDB1);

        /* LED */
        DDRD |= _BV(DDD7);

        for (;;) {
            PORTD ^= _BV(PORTD7);
            _delay_ms(500);
        }
    }

Pay attention to AVR GPIO sequencing.

The PB1 output latch should be LOW before or at the same time PB1 becomes an output.

Do not configure Timer1.

Do not configure TWI.

Do not configure ADC.

Do not configure INT0.

Do not touch PD3.

Do not enable HV.

Do not write fuses.

======================================================================
16. INITIAL CLOCK ISSUE
======================================================================

The LED delay is not considered proof of an 8 MHz clock unless fuse configuration is known.

If the MCU is running at 1 MHz because CKDIV8 is enabled while firmware was compiled with:

    F_CPU=8000000UL

then delay timing will be wrong by approximately 8x.

Therefore:

1. Read fuses FIRST.
2. Decode clock configuration.
3. Compile Phase 2 with F_CPU matching the actual clock.
4. Flash LED firmware.
5. Measure behavior.
6. Later change fuses only after explicit review.

======================================================================
17. PHASE 2 SUCCESS CRITERIA
======================================================================

Do not proceed unless:

- Atmel-ICE detects target
- ATmega328PB device signature is correct
- fuse bytes can be read
- original fuse values are saved
- build succeeds with no important warnings
- flash succeeds
- verify succeeds
- LED blinks
- PB1 measures LOW
- HV converter remains inactive
- supply current is reasonable
- no component heats unexpectedly

======================================================================
18. PHASE 3 — CLOCK AND FUSE REVIEW
======================================================================

DO NOT automatically perform this phase.

After Phase 2 is confirmed:

Determine desired final configuration:

    internal RC oscillator
    8 MHz CPU clock
    CKDIV8 disabled
    ISP retained
    RESET retained
    debugWIRE disabled

Propose a suitable BOD configuration for a nominal 3.3 V rail.

Do not assume a particular BOD fuse value without checking the ATmega328PB datasheet.

Prepare a report:

CURRENT:
    LFUSE = ...
    HFUSE = ...
    EFUSE = ...

Decode each implemented bit.

PROPOSED:
    LFUSE = ...
    HFUSE = ...
    EFUSE = ...

Decode each implemented bit.

Explicitly highlight any changed bit.

If SPIEN, RSTDISBL, DWEN or clock-source selection would change unexpectedly:

    STOP.

Do not produce an executable fuse command until a human explicitly says the proposed fuse configuration is approved.

======================================================================
19. PHASE 4 — CLOCK VERIFICATION
======================================================================

Before and after any approved fuse change:

Generate a known frequency using hardware timer output or GPIO timing.

Measure it with:
- oscilloscope
or
- logic analyzer

Do not infer clock frequency only from LED blinking.

After final configuration verify:

    actual CPU clock ≈ 8 MHz

Then set normal project default:

    F_CPU = 8000000UL

======================================================================
20. PHASE 5 — LOW-VOLTAGE PERIPHERAL BRING-UP
======================================================================

Bring up one peripheral at a time:

A. LED

B. GM_PULSE / INT0

C. ADC0 / HV_ADC with HV OFF

D. TWI0 slave

No buzzer test exists.

PD3 remains spare.

======================================================================
21. GM_PULSE TEST
======================================================================

Configure:

    PD2 / INT0
    falling-edge trigger

ISR:

    ISR(INT0_vect)
    {
        gm_pulse_count++;
    }

Use an appropriate volatile counter.

Do not perform application work inside ISR.

Main code may atomically copy and inspect the pulse count.

Provide a way to inject a low-going test pulse before connecting/depending on an actual GM tube signal.

======================================================================
22. ADC TEST
======================================================================

Configure ADC0.

Reference:
    internal nominal 1.1 V

HV remains OFF.

Provide:

    uint16_t adc_read_hv_raw(void);

and pure conversion helpers such as:

    uint32_t adc_raw_to_uv(uint16_t raw, uint32_t vref_uv);
    uint32_t hv_adc_to_voltage(...);

Do not use floating point unless there is a strong reason.

Use fixed-point/integer arithmetic.

Keep these constants centralized:

- ADC resolution
- nominal Vref
- measured/calibrated Vref
- high-side divider resistance
- low-side divider resistance

======================================================================
23. TWI SLAVE TEST
======================================================================

Configure TWI0 as slave:

    address 0x66

Initial register implementation:

    0x00 -> 0x7D

and:

    0x06
    0x07
    0x08

return a fixed synthetic radiation value.

Implement a small register pointer protocol.

Required:
- write register address
- repeated START
- read
- sequential reads
- STOP handling

Do not allocate memory dynamically.

Do not perform slow application work inside the TWI ISR.

======================================================================
24. I2C HARDWARE TEST
======================================================================

Test with the real Seeed Solar Node / Grove connection.

Measure both sides of the BSS138 translators.

HOST:
    SDA_HOST
    SCL_HOST

INTERNAL:
    SDA
    SCL

Verify:
- internal HIGH ≈ 3.3 V
- actual HOST HIGH voltage
- proper LOW levels
- sensible rise times
- no bus contention

Run I2C scan.

Expected devices include:
- GeigerNode at 0x66
- onboard BME680 at its strapped address

Then test BME680 isolation jumpers:

1. onboard sensor connected:
   BME680 should appear.

2. open both BME680 SDA/SCL jumpers:
   onboard BME680 should disappear.

3. GeigerNode ATmega 0x66 must remain functional.

4. external sensor on AUX should remain usable.

======================================================================
25. PHASE 6 — RADSENS EMULATION
======================================================================

Only after TWI is stable.

Implement a register bank.

Minimum:

    0x00 = 0x7D

Synthetic static radiation:

    0x06..0x08

Use an atomic/coherent snapshot.

Never allow a three-byte read to combine bytes from two different measurement updates.

Example:

    uint32_t static_radiation_x10;

When publishing:
- build all three register bytes from one snapshot
- make register update atomic relative to TWI access

======================================================================
26. PHASE 7 — HV OPEN-LOOP BRING-UP
======================================================================

DO NOT ENABLE UNTIL EXPLICITLY REQUESTED.

HV hardware:
- PB1 / OC1A
- Timer1

Initial test must be open-loop.

Start conservatively.

Suggested initial characterization region:

    pulse width: approximately 20–30 us
    repetition: approximately 500–1000 Hz

During Rev-A characterization:

    hard maximum pulse width <= 100 us

This maximum must exist independently from feedback regulation.

Procedure:

1. Keep HV power stage disabled if possible.
2. Configure Timer1.
3. Scope PB1.
4. Verify pulse width.
5. Verify period.
6. Verify reset returns PB1 LOW.
7. Verify firmware fault returns PB1 LOW.
8. Current-limit board supply.
9. Energize converter.
10. Use proper HV probe.
11. Measure Q1 collector waveform.
12. Check ringing/overshoot.
13. Measure actual HV.
14. Compare ADC feedback.

Increase HV progressively:

    ~100 V
    ~200 V
    ~300 V
    upper-300 V region

Do NOT immediately command 400 V.

Characterize the hardware before implementing closed-loop control.

======================================================================
27. PHASE 8 — HV CLOSED LOOP
======================================================================

After open-loop characterization.

Use explicit state machine:

    HV_OFF
    HV_STARTING
    HV_REGULATING
    HV_FAULT

Every transition must be understandable.

HV_FAULT must force:

    PB1 LOW
    Timer1 output disconnected

Possible fault conditions:

- ADC overvoltage
- invalid ADC value
- startup timeout
- excessive drive demand
- watchdog/reset
- explicit OFF command

Add hard limits independent of regulator output.

For example:

    requested_on_time =
        min(regulator_requested_on_time,
            HARD_MAX_ON_TIME);

Never allow regulator wind-up to result in continuous drive.

======================================================================
28. PHASE 9 — REAL GM MEASUREMENT
======================================================================

After HV is stable.

INT0 counts pulses.

Maintain:
- total pulse count
- measurement-window pulse count
- CPM
- dynamic estimate
- static estimate

Use configurable tube sensitivity coefficient:

    S = impulses / uR

Conversion:

    uR/h = CPM * 60 / S

RadSens representation:

    raw = uR/h * 10

Store:

    reg[0x06] = (raw >> 16) & 0xff;
    reg[0x07] = (raw >> 8)  & 0xff;
    reg[0x08] = raw & 0xff;

Use fixed-point arithmetic where practical.

Do not permanently bake calibration into unrelated source files.

Keep calibration constants together.

======================================================================
29. PRODUCTION ARCHITECTURE
======================================================================

Use pure C.

No:
- malloc
- calloc
- realloc
- free
- floating runtime dependency unless justified
- C++ runtime
- Arduino
- framework callbacks

Suggested final modules:

include/
    board.h
    gpio.h
    adc.h
    gm_counter.h
    twi_slave.h
    radsens.h
    hv.h
    watchdog.h
    radiation.h

src/
    main.c
    gpio.c
    adc.c
    gm_counter.c
    twi_slave.c
    radsens.c
    hv.c
    watchdog.c
    radiation.c

Timer allocation target:

Timer1:
    HV pulse generation

Timer2:
    available for system timing / scheduler if useful

INT0:
    GM pulses

TWI0:
    RadSens slave

ADC0:
    HV feedback

======================================================================
30. MAIN LOOP DESIGN
======================================================================

Target architecture:

INT0 ISR:
    increment GM count
    return

TWI ISR:
    advance transaction state
    return

timer ISR:
    minimal scheduling counters only
    return

main:
    process elapsed-time flags
    copy GM counts atomically
    calculate CPM
    calculate radiation
    update RadSens register snapshot
    service HV regulator
    service fault state
    service LED
    reset watchdog

Avoid blocking code in production.

_delay_ms() is acceptable only for early LED bring-up.

======================================================================
31. WATCHDOG
======================================================================

Do not enable watchdog blindly during Phase 1.

First inspect:
- reset cause
- WDTON fuse
- existing watchdog state

Production firmware should eventually use watchdog.

On startup:
- capture/reset MCUSR appropriately
- establish safe HV state
- configure watchdog intentionally

Any watchdog reset must result in HV OFF.

======================================================================
32. CODE QUALITY
======================================================================

Prefer:
- small modules
- explicit register operations
- explicit integer types
- uint8_t / uint16_t / uint32_t
- static functions where appropriate
- const data
- simple state machines
- compile-time constants
- comments explaining hardware reasons

Avoid:
- unnecessary macros
- clever metaprogramming
- magic numbers
- duplicated register configuration
- huge ISRs
- global mutable state without reason

Use:
    <avr/io.h>
    <avr/interrupt.h>
    <avr/atomic.h>
    <avr/wdt.h>
    <util/delay.h>

where appropriate.

======================================================================
33. FIRST CURSOR TASK
======================================================================

DO NOT implement the full firmware yet.

For the first response, create ONLY:

    Makefile
    README.md
    bringup/README.md
    include/board.h
    src/main.c

The firmware must:

1. target ATmega328PB
2. build using avr-gcc
3. program with Atmel-ICE ISP
4. provide read-signature command
5. provide read-fuses command
6. NEVER write fuses
7. NEVER enable HV
8. force PB1 LOW
9. blink LED PD7
10. leave PD3 unused
11. leave Timer1 disabled
12. leave Timer2 disabled
13. leave TWI disabled
14. leave ADC disabled
15. leave INT0 disabled

Do not create buzzer functionality.

======================================================================
34. FIRST RESPONSE FORMAT
======================================================================

Show the complete contents of:

1. Makefile
2. include/board.h
3. src/main.c
4. README.md
5. bringup/README.md

Then provide the exact human bring-up procedure:

1. inspect PCB
2. resistance checks
3. connect current-limited external supply
4. verify 3.3 V
5. verify no unexpected heating
6. connect Atmel-ICE
7. read device signature
8. read fuse bytes
9. SAVE fuse bytes
10. decode current clock configuration
11. select matching F_CPU
12. build
13. inspect avr-size
14. flash
15. verify
16. observe LED
17. scope/measure PB1
18. confirm PB1 remains LOW
19. record results

STOP THERE.

Do not proceed to:
- fuse writing
- I2C
- ADC
- GM interrupt
- HV PWM
- closed-loop regulation

until the user provides the measured bring-up results.

======================================================================
35. FINAL FUSE REMINDER
======================================================================

FUSE VALUES ARE NOT ORDINARY FIRMWARE CONFIGURATION.

An incorrect fuse write can:
- select the wrong clock source
- disable ISP
- disable RESET
- enable unwanted debug behavior
- make the MCU appear dead

Therefore:

READ -> SAVE -> DECODE -> PROPOSE -> REVIEW -> HUMAN APPROVAL -> WRITE

Never:

GUESS -> WRITE
