CZ-Infokom/GeigerNode/hardware/production/bom.csv

Designator | Footprint | Quantity | Value | LCSC Part #
C1, C10, C11, C2, C4, C7, C9 | 0805 | 7 | 100nF
C12, C13 | 0805 | 2 | 4.7uF | C415536
C14, C15 | 0805 | 2 | 100nF | C396717
C3 | 1206 | 1 | 10uF
C5 | 0805 | 1 | 10uF
C6 | 1206 | 1 | 10nF, 1kV | C344191
C8 | 1206 | 1 | 220pF, 1kV | C22374883
D1 | D_SMA | 1 | US1M | C22448038
D3 | D_SOD-123 | 1 | 1N4148W | C115103
D4 | 0805 | 1 | LED
J1 | Tag-Connect_TC2030-IDC-FP_2x03_P1.27mm_Vertical | 1 | AVR-ISP-6
J2, J3 | JST_PH_B4B-PH-K_1x04_P2.00mm_Vertical | 2 | CAX PHB-4A | C2847689
L1 | L_12x12mm_H4.5mm | 1 | 10mH | C718296
Q1 | SOT-23 | 1 | STR1550 | C907714
Q2 | SOT-23 | 1 | MMBT3904 | C280057
Q4, Q5 | SOT-23 | 2 | BSS138 | C52895
R1, R15, R5 | 0805 | 3 | 10kΩ
R10, R14 | 0805 | 2 | 100kΩ
R11, R12, R19, R20 | 1206 | 4 | 1.2MΩ | C2889803
R13 | 0805 | 1 | 22kΩ
R16 | 0805 | 1 | 2.2kΩ
R2, R21, R22, R3 | 0805 | 4 | 4.7kΩ
R4 | 0805 | 1 | 470Ω
R6, R7, R8, R9 | 1206 | 4 | 10MΩ | C326960
TP1 | TestPoint_Pad_D2.0mm | 1 | HV 400V
TP2 | TestPoint_Pad_D2.0mm | 1 | GM PULSE
U1 | TQFP-32_7x7mm_P0.8mm | 1 | ATMEGA328PB-AU | C132230
U2 | Bosch_LGA-8_3x3mm_P0.8mm_ClockwisePinNumbering | 1 | BME680 | C125972
U3 | SOT-23-5 | 1 | TLV75533PDBV | C404027
V1 | SBM-20 | 1 | SBM-20 / SI-3BG / SI-1G
