CZ-Infokom/GeigerNode/hardware/GeigerNode.kicad_pcb

## KiCad design hardware/GeigerNode.kicad_pcb (2026-11-09)

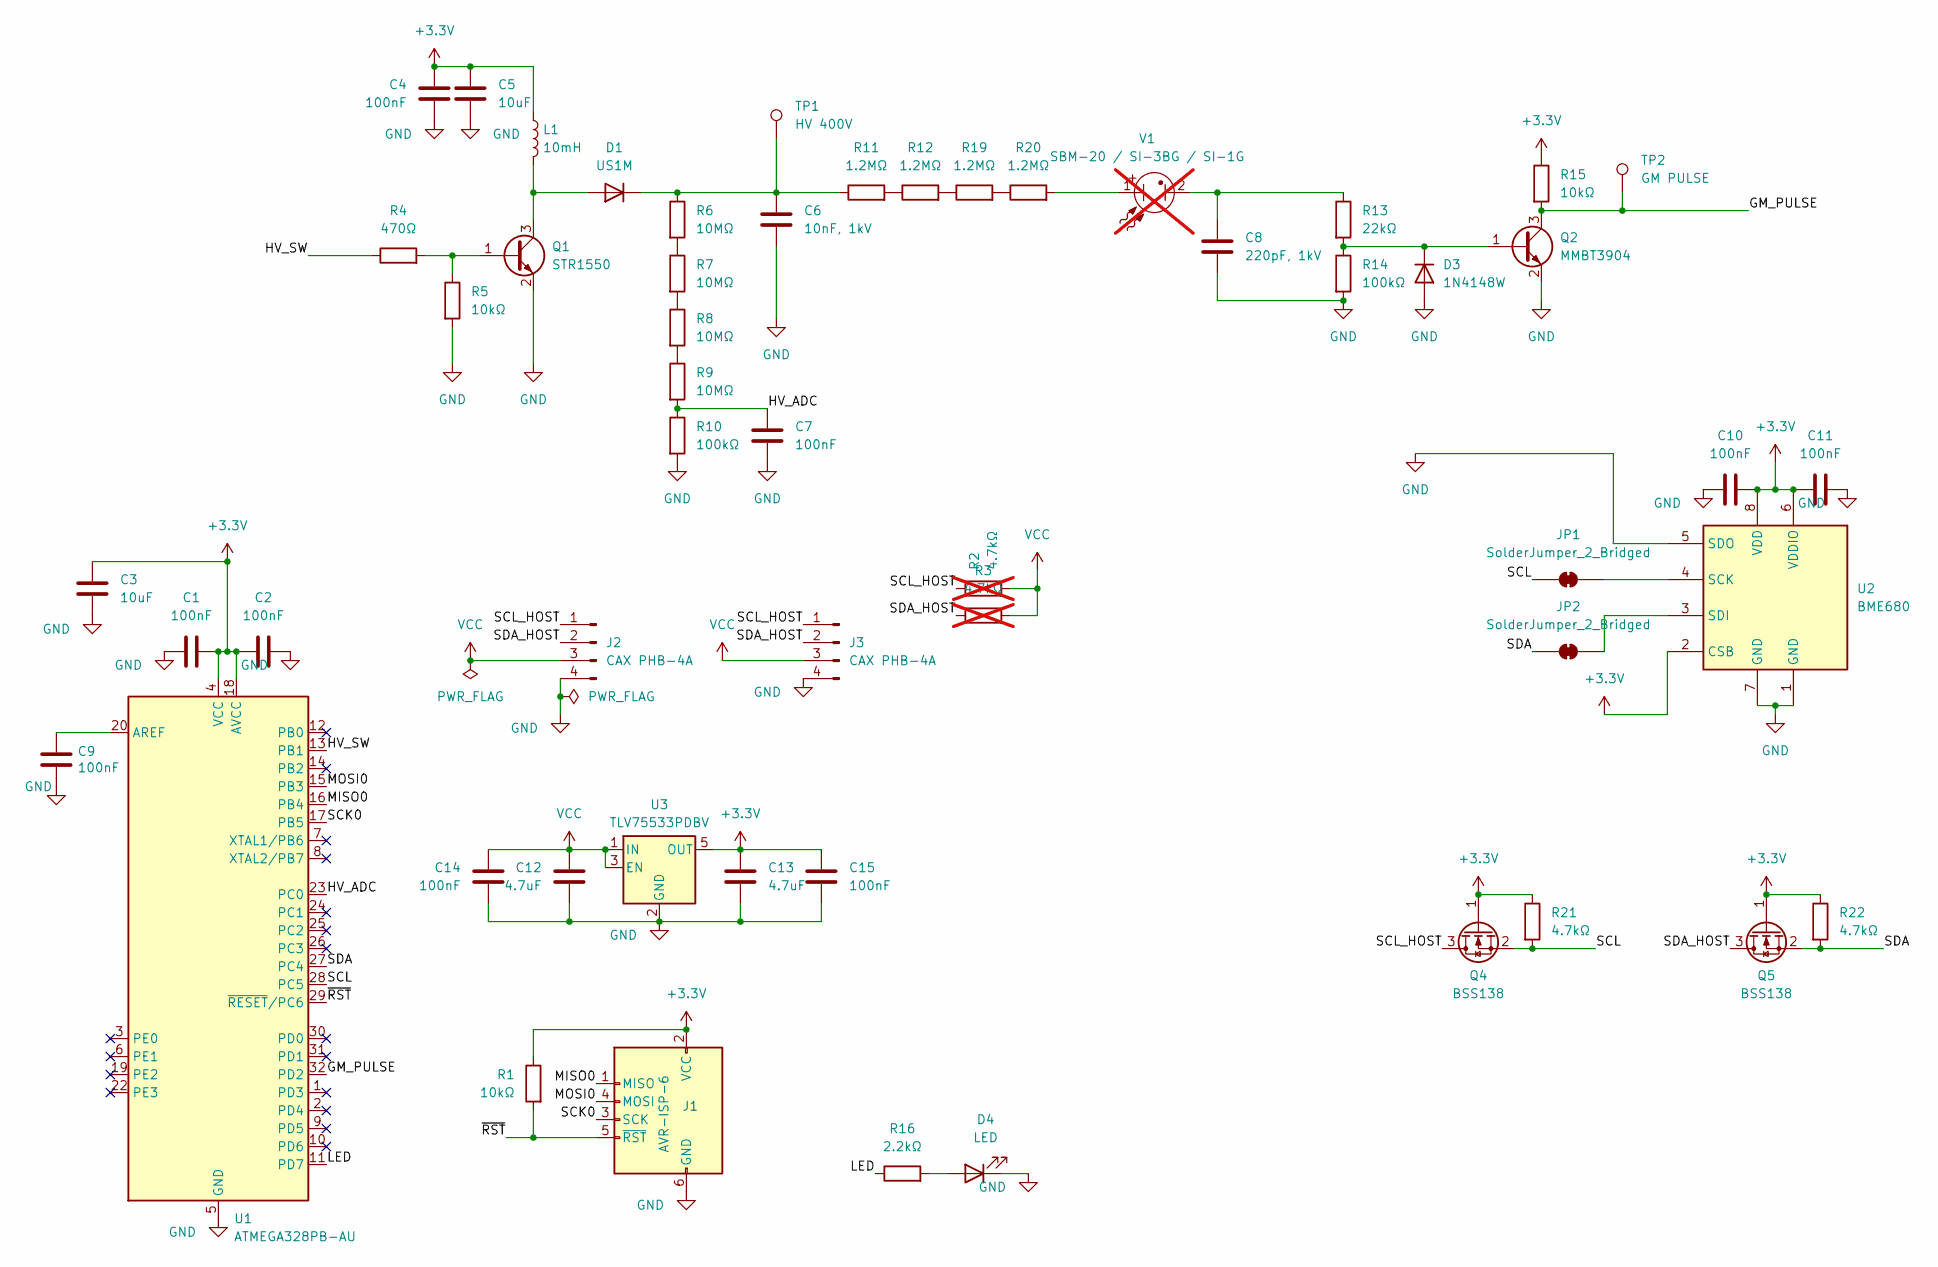
[picture p1: schematic GeigerNode.kicad_sch, Geiger Node]

Parts:
C1, C2, C4, C7, C9, C10, C11: 100nF; C_0805_2012Metric
C3: 10uF; C_1206_3216Metric
C5: 10uF; C_0805_2012Metric
C6: 10nF, 1kV; C_1206_3216Metric; JLC C344191
C8: 220pF, 1kV; C_1206_3216Metric; JLC C22374883
C12, C13: 4.7uF; C_0805_2012Metric; JLC C415536
C14, C15: 100nF; C_0805_2012Metric; JLC C396717
D1: US1M; D_SMA; JLC C22448038
D3: 1N4148W; D_SOD-123; JLC C115103
D4: LED; D_0805_2012Metric
J1: AVR-ISP-6; Tag-Connect_TC2030-IDC-FP_2x03_P1.27mm_Vertical
J2, J3: CAX PHB-4A; JST_PH_B4B-PH-K_1x04_P2.00mm_Vertical; JLC C2847689
JP1, JP2: SolderJumper_2_Bridged; SolderJumper-2_P1.3mm_Bridged_RoundedPad1.0x1.5mm
L1: 10mH; L_12x12mm_H4.5mm; JLC C718296
Q1: STR1550; SOT-23; JLC C907714
Q2: MMBT3904; SOT-23; JLC C280057
Q4, Q5: BSS138; SOT-23; JLC C52895
R1, R5, R15: 10kΩ; R_0805_2012Metric
R2, R3: 4.7kΩ; R_0805_2012Metric; not fitted
R4: 470Ω; R_0805_2012Metric
R6, R7, R8, R9: 10MΩ; R_1206_3216Metric; JLC C326960
R10, R14: 100kΩ; R_0805_2012Metric
R11, R12, R19, R20: 1.2MΩ; R_1206_3216Metric; JLC C2889803
R13: 22kΩ; R_0805_2012Metric
R16: 2.2kΩ; R_0805_2012Metric
R21, R22: 4.7kΩ; R_0805_2012Metric
TP1: HV 400V; TestPoint_Pad_D2.0mm
TP2: GM PULSE; TestPoint_Pad_D2.0mm
U1: ATMEGA328PB-AU; TQFP-32_7x7mm_P0.8mm; JLC C132230
U2: BME680; Bosch_LGA-8_3x3mm_P0.8mm_ClockwisePinNumbering; JLC C125972
U3: TLV75533PDBV; SOT-23-5; JLC C404027
V1: SBM-20 / SI-3BG / SI-1G; SBM-20; not fitted

Connections:
+3.3V: C1.2, C2.1, C3.1, C4.1, C5.1, C10.2, C11.1, C13.1, C15.1, J1.2 (VCC), L1.1, Q4.1 (G), Q5.1 (G), R1.1, R15.1, R21.1, R22.1, U1.4 (VCC), U1.18 (AVCC), U2.2 (CSB), U2.6 (VDDIO), U2.8 (VDD), U3.5 (OUT)
/GM_PULSE: Q2.3 (C), R15.2, TP2.1 (1_1), U1.32 (PD2)
/HV_ADC: C7.1, R9.2, R10.1, U1.23 (PC0)
/HV_SW: R4.1, U1.13 (PB1)
/LED: R16.1, U1.11 (PD7)
/MISO0: J1.1 (MISO), U1.16 (PB4)
/MOSI0: J1.4 (MOSI), U1.15 (PB3)
/SCK0: J1.3 (SCK), U1.17 (PB5)
/SCL: JP1.1 (A), Q4.2 (S), R21.2, U1.28 (PC5)
/SCL_HOST: J2.1, J3.1, Q4.3 (D), R2.1
/SDA: JP2.1 (A), Q5.2 (S), R22.2, U1.27 (PC4)
/SDA_HOST: J2.2, J3.2, Q5.3 (D), R3.1
/~RST: J1.5 (~RST), R1.2, U1.29 (~RESET/PC6)
GND: C1.1, C2.2, C3.2, C4.2, C5.2, C6.2, C7.2, C8.2, C9.2, C10.1, C11.2, C12.2, C13.2, C14.2, C15.2, D3.2 (A), D4.1 (K), J1.6 (GND), J2.4, J3.4, Q1.2 (E), Q2.2 (E), R5.2, R10.2, R14.2, U1.5 (GND), U1.21 (GND), U2.1 (GND), U2.5 (SDO), U2.7 (GND), U3.2 (GND)
unnamed: C8.1, R13.1, V1.2
unnamed: D1.2 (A), L1.2, Q1.3 (C)
unnamed: C6.1, D1.1 (K), R6.1, R11.1, TP1.1 (1_1)
unnamed: D3.1 (K), Q2.1 (B), R13.2, R14.1
unnamed: D4.2 (A), R16.2
unnamed: JP1.2 (B), U2.4 (SCK)
unnamed: JP2.2 (B), U2.3 (SDI)
unnamed: Q1.1 (B), R4.2, R5.1
unnamed: R6.2, R7.1
unnamed: R7.2, R8.1
unnamed: R8.2, R9.1
unnamed: R11.2, R12.1
unnamed: R12.2, R19.1
unnamed: R19.2, R20.1
unnamed: R20.2, V1.1
unnamed: C9.1, U1.20 (AREF)
VCC: C12.1, C14.1, J2.3, J3.3, R2.2, R3.2, U3.1 (IN), U3.3 (EN)

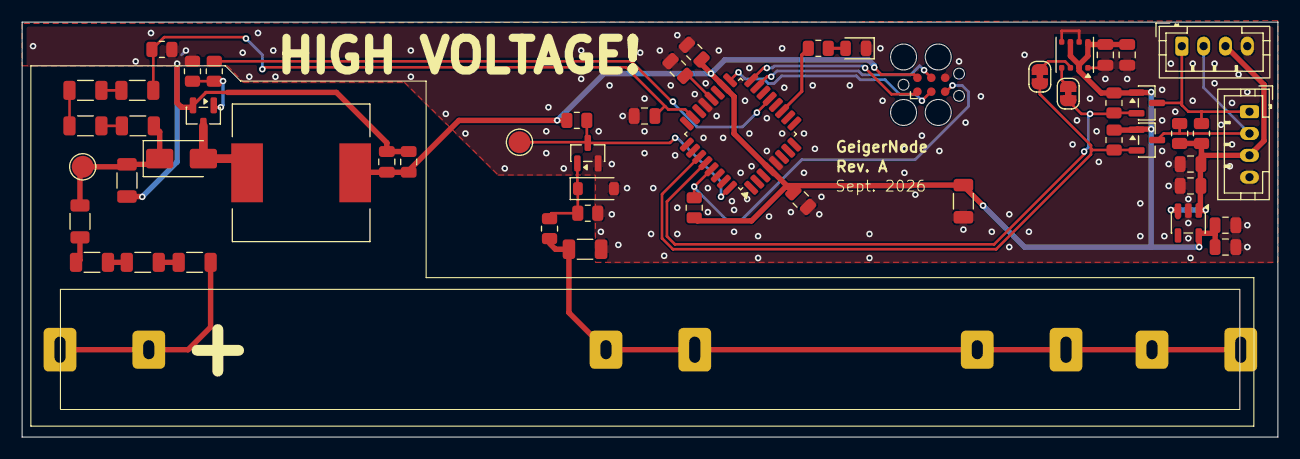
[picture p2: board GeigerNode.kicad_pcb from above]

Board: 2 copper layers, 115.0 x 38.0 mm, 54 parts (0 on the bottom side), 31 nets.
