CZ-Infokom/GeigerNode/(commit log)

2026-10-01 Add the Phase 2 bring-up image and the board 01 record.
    The firmware holds the HV switch low and blinks the LED at the measured 1 MHz clock. Signature and fuse bytes are saved, and fuse programming stays disabled.
2026-10-01 Record the approved 8 MHz fuse write.
    make fuses now programs only the reviewed fuse bytes. The board read 0xE2, 0xD9, and 0xF5 back, and ISP still works.
2026-10-01 Record the measured 8 MHz clock and use it as the build default.
    PD7 measured 500 Hz after the fuse change, so F_CPU now defaults to 8 MHz.
2026-10-01 Blink the LED from a 1 ms tick and record the Phase 5A pass.
    The high-voltage switch stays driven low while the LED toggles every 500 ms. The board showed that blink.
2026-10-01 Count Geiger pulses on PD2 and record the Phase 5B pass.
    A falling edge only increments the counter. The LED flickers when pulses arrive, and the high-voltage switch stays low.
2026-10-01 Read the HV ADC with the converter off and record raw 5.
    The LED blinks the ADC count. Five counts convert to about 2.15 V, matching the earlier meter reading.
2026-10-01 Add the TWI slave and record that its bus test was not run.
    The slave address is 0x66 with the RadSens ID and a fixed radiation value. The user asked to assume it works until a master can read it back.
    [board.h, main.c, twi_slave.c, twi_slave.h]
2026-10-01 Record the open-loop HV pulse after the PB1 checks passed.
    Timer1 drives a 25 us pulse at 500 Hz, then latches PB1 low. The scope matched that pulse, and the HV output was 43.7 V.
2026-10-01 Record the 40 us open-loop step at 57.5 V.
    The same 500 Hz pulse, widened from 25 us, passed the PB1 checks. Output rose from 43.7 V to 57.5 V.
2026-10-02 Record the closed-loop HV characterization and freeze the 380 V limits.
    The sweeps established the tube target, frequency band, pulse cap, and production abort so later firmware does not keep climbing.
2026-10-02 Hold 380 V at 2500 Hz and record the production-hold check.
    The Q1-diode peak was 427.4 V and thermals were OK, with the abort set around 400 V so the regulator no longer climbs through the characterization ceiling.
    [board.h, hv.c, hv.h, main.c]
2026-10-05 Count every SI-29BG edge at 380 V and record the tube runs.
    The one-shot window times gaps at 1 us, starts only on a real power-on, and leaves blanking at 0.
2026-10-05 Publish RadSens registers on TWI 0x66 and restart each read at the written pointer.
    Static dose is the last 60 s, dynamic dose is the last 10 s, and an I2C write cannot start or stop HV.
2026-10-07 Bit-bang the RadSens slave so a 100 kHz master can read 0x66.
    Hardware TWI could hold SCL, and a C interrupt prologue missed Flipper's address bit. The pin-change handler ACKs in time, and the register map records where radiation is published.
    [board.h, twi_slave.c, twi_slave.h]
2026-11-06 Serve the RadSens map on hardware TWI0.
    The pin-change slave held the bus for a whole transfer and could corrupt multi-byte reads. TWI0 keeps the pointer across STOP and repeated START, latches radiation on SLA+R, and leaves the bit-bang image on fallback/bitbang-i2c.
2026-11-06 Record the ESP32-C3 28-check hardware TWI0 pass.
2026-11-06 Serve native I2C protocol v1 alongside RadSens at compile time.
    PROTOCOL=native or PROTOCOL=radsens selects the map; make has no default.
2026-11-06 Add PCB rev A beside the firmware that brings those boards up.
    [GeigerNode.kicad_pcb, GeigerNode.kicad_sch, bom.csv, designators.csv, positions.csv]
2026-11-07 Count with a 300 µs holdoff and publish native protocol v2.
    The holdoff, the 300 s window, and the SBM-20 calibration stay the defaults. Native lets a host set the window from 1 s to 400 s, the holdoff from 0 µs to 300 µs, and a non-zero calibration. RadSens keeps the fixed window and holdoff.
    [gm_counter.c, gm_counter.h, gm_test.c, gn_config.c, gn_config.h, gn_protocol.h, main.c, radsens.c]
2026-11-07 Publish the native inter-arrival histogram and cut static RAM.
    Native v2 keeps protocol 2 and exposes the nine INT0 bins at 0x22..0x38. Both images drop the TWI latch copy, RadSens drops the unused slip array, and the Flipper pair is v0.2.1-beta.2.
    [geigernode_viewer.py, gm_counter.c, gm_counter.h, gn_protocol.h, main.c, test_decode.py, twi_slave.c, twi_slave.h]
2026-11-08 Add a CI workflow that releases HEX and Flipper images on version tags.
    Pre-release suffixes such as -beta, -rc, and -pre stay off the Latest release, and the Flipper descriptors keep the approved fuse bytes.
2026-11-08 Publish short-slice peaks as the 0.2.1-beta.4 image.
    A 300 s average hides a brief source when background is about 30 CPM. Native v2 keeps the busiest 10–60 s slice in the dose window and a latched copy that clears on read.
    [geigernode_viewer.py, gm_counter.c, gm_counter.h, gn_config.c, gn_config.h, gn_protocol.h, main.c, test_decode.py]
2026-11-08 Ship 0.2.1 with viewer trace toggles and actual-span charts.
2026-11-09 Removed PCB Infokom branding
    [GeigerNode.kicad_pcb, designators.csv]
